ingolia-lab/turbidostat-development/nephelometer/doc/README.md

### Ingolia lab turbidostat

#### [Operating the turbidostat](operation.md)

* [Sterilizing the media reservoir and growth chamber](sterilization.md). 
   
* [Filling the media reservoir](media-fill.md). 
   
* [Starting a turbidostat culture](turbidostat.md).

* [Dissassembly and cleanup](cleanup.md).

#### [Constructing the turbidostat](construction.md)

1. [Electronics](./construction-electronics.md) to assemble the printed circuit board
1. [Housing](./construction-housing.md) to print the enclosure and mount the assembled circuit
1. [Pump](./construction-pump.md) to mount and wire the media pump
1. [Fluidics](./construction-fluidics.md) to assemble the growth chamber, media reservoir, and other associated fluidics
