ingolia-lab/turbidostat-development/nephelometer/doc/raw-images/IMG_1793.JPG

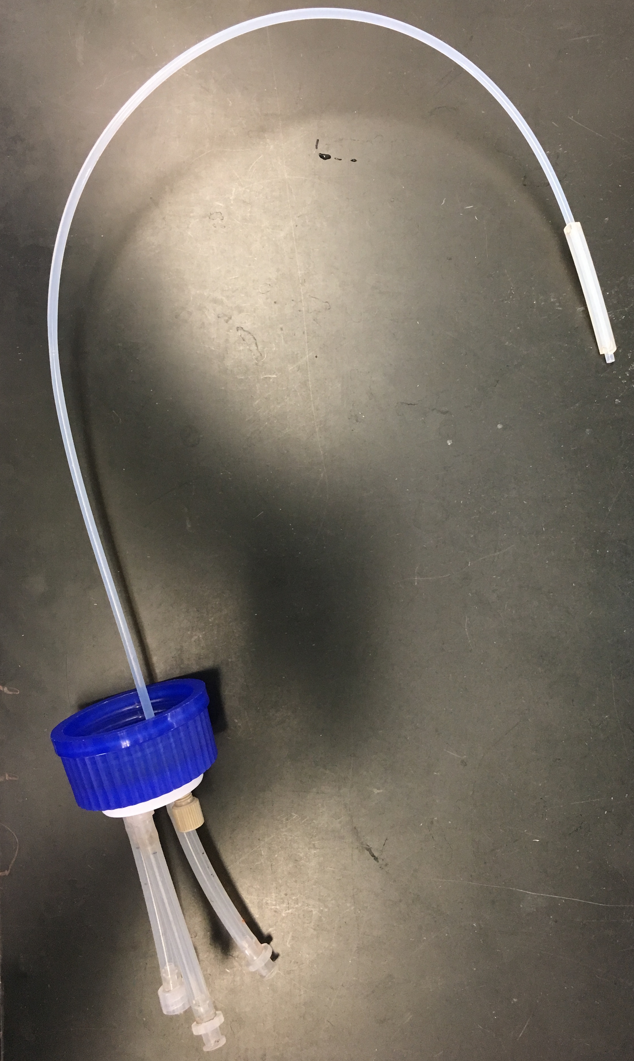
nephelometer/doc/raw-images/IMG_1793.JPG
