ingolia-lab/turbidostat-development/nephelometer/doc/raw-images/IMG_1794.JPG

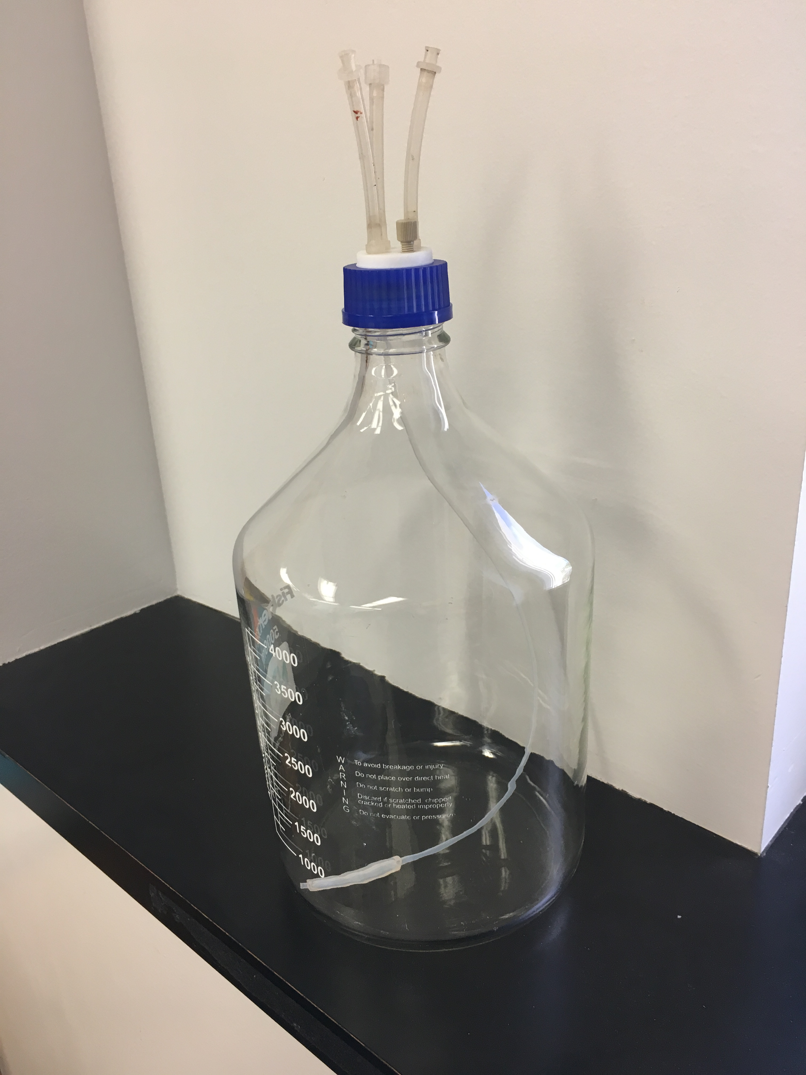
nephelometer/doc/raw-images/IMG_1794.JPG
