ingolia-lab/turbidostat-development/nephelometer/doc/raw-images/IMG_1795.JPG

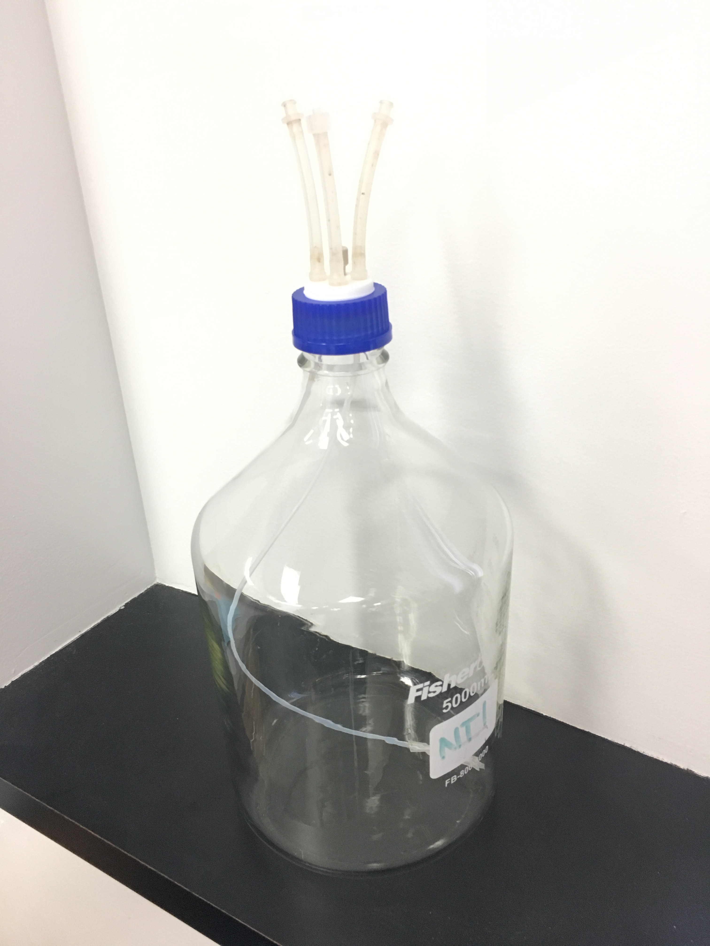
nephelometer/doc/raw-images/IMG_1795.JPG
