ingolia-lab/turbidostat-development/nephelometer/doc/raw-images/IMG_1796.JPG

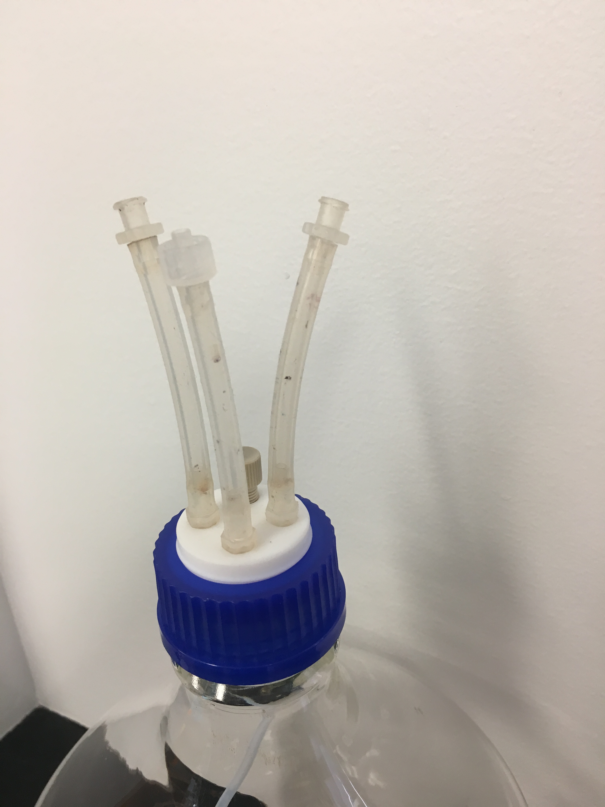
nephelometer/doc/raw-images/IMG_1796.JPG
