ingolia-lab/turbidostat-development/nephelometer/doc/raw-images/IMG_1797.JPG

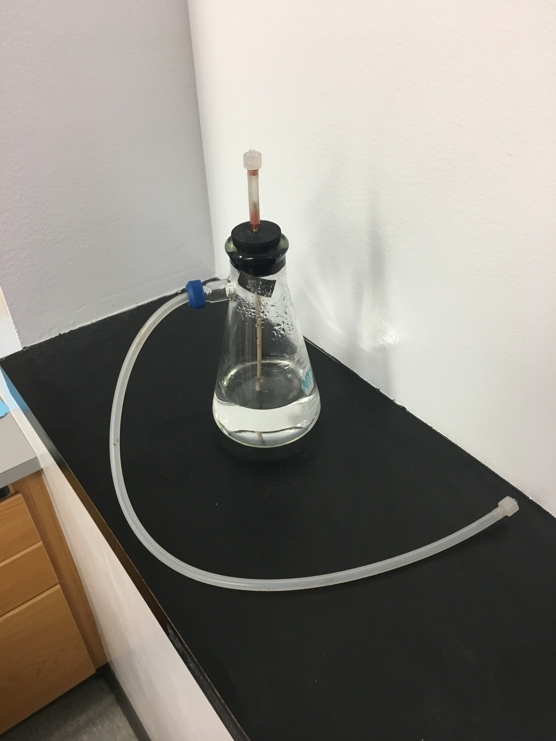
nephelometer/doc/raw-images/IMG_1797.JPG
