ingolia-lab/turbidostat-development/nephelometer/doc/raw-images/IMG_1798.JPG

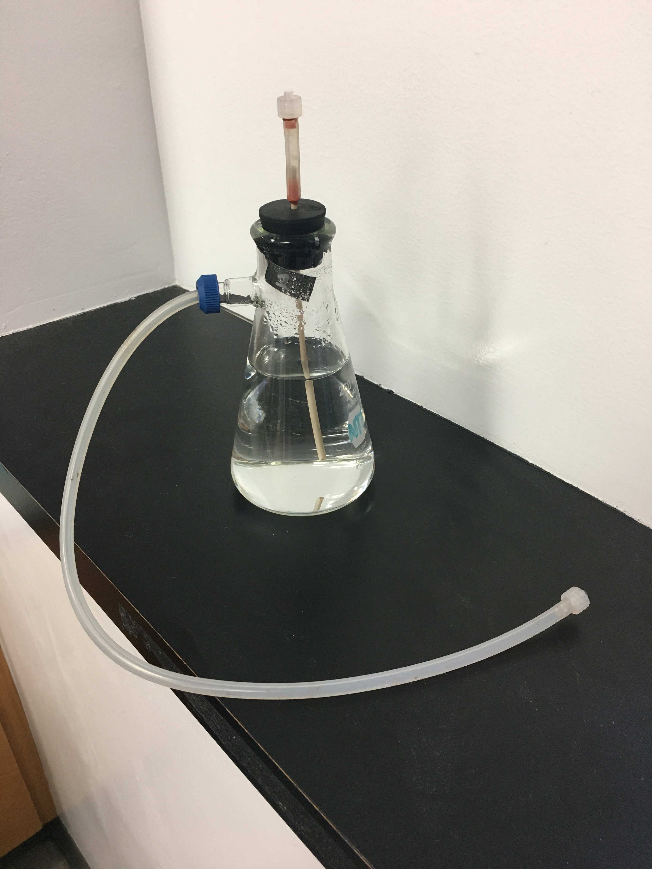
nephelometer/doc/raw-images/IMG_1798.JPG
