ingolia-lab/turbidostat-development/nephelometer/doc/raw-images/IMG_1799.JPG

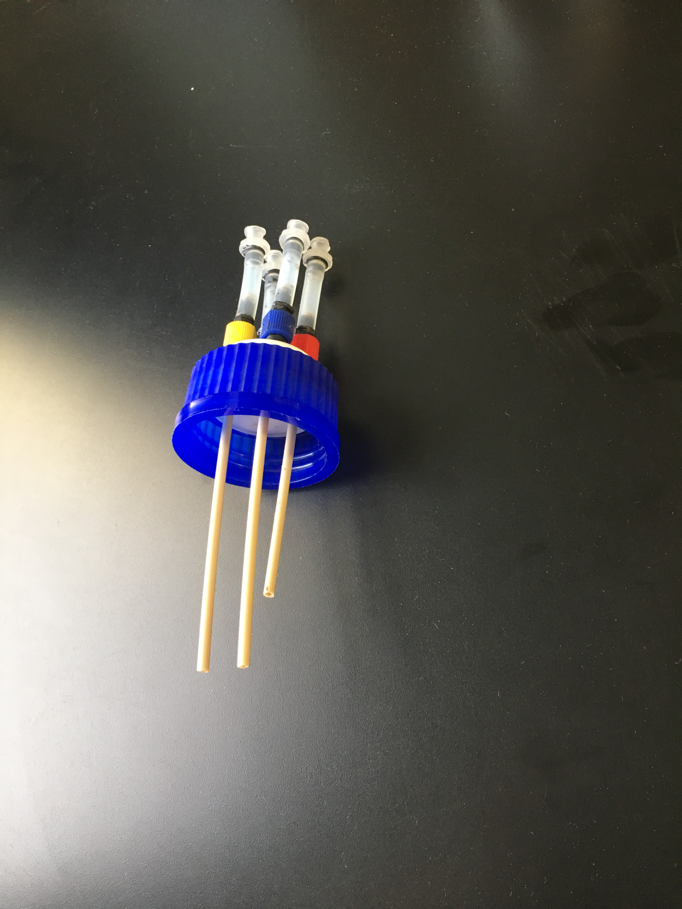
nephelometer/doc/raw-images/IMG_1799.JPG
