ingolia-lab/turbidostat-development/nephelometer/doc/raw-images/IMG_1800.JPG

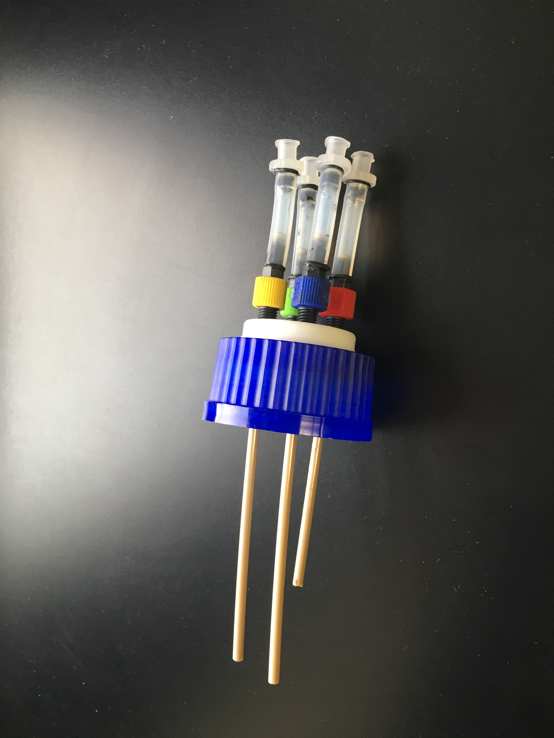
nephelometer/doc/raw-images/IMG_1800.JPG
