ingolia-lab/turbidostat-development/nephelometer/doc/raw-images/IMG_1801.JPG

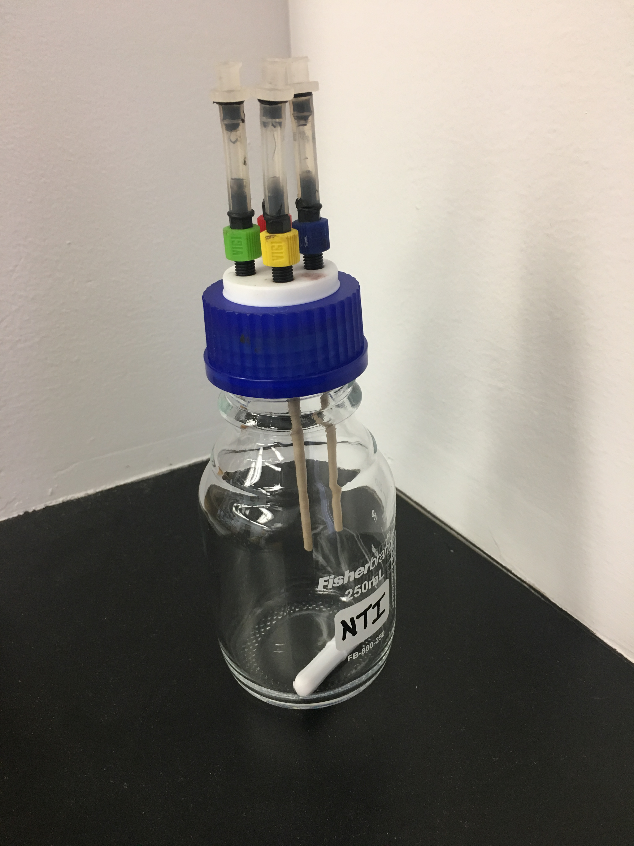
nephelometer/doc/raw-images/IMG_1801.JPG
