ingolia-lab/turbidostat-development/nephelometer/doc/raw-images/IMG_1802.JPG

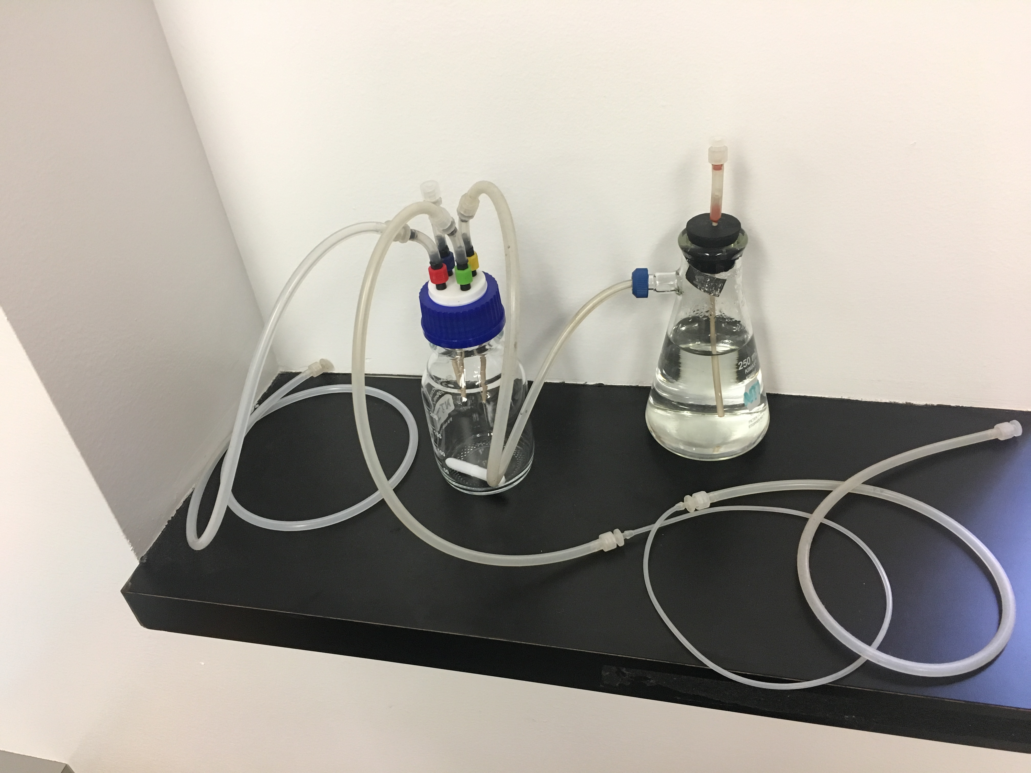
nephelometer/doc/raw-images/IMG_1802.JPG
