ingolia-lab/turbidostat-development/nephelometer/doc/raw-images/IMG_1803.JPG

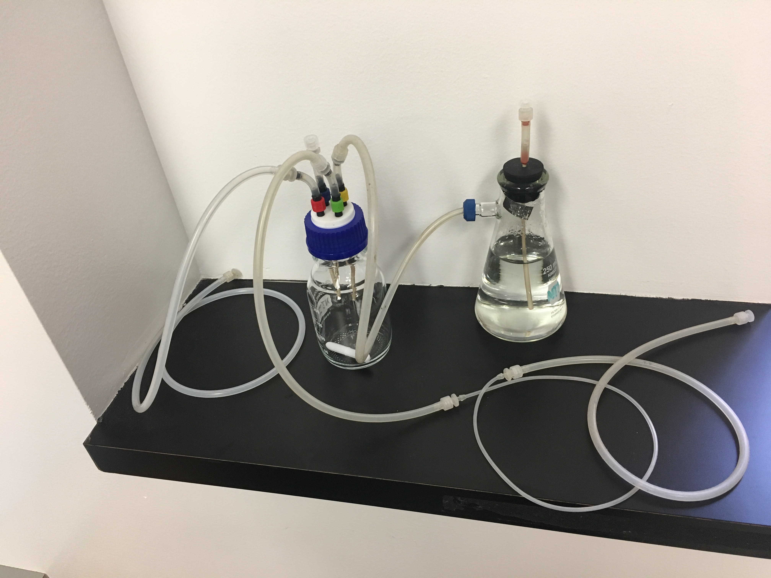
nephelometer/doc/raw-images/IMG_1803.JPG
