ingolia-lab/turbidostat-development/nephelometer/doc/raw-images/IMG_1804.JPG

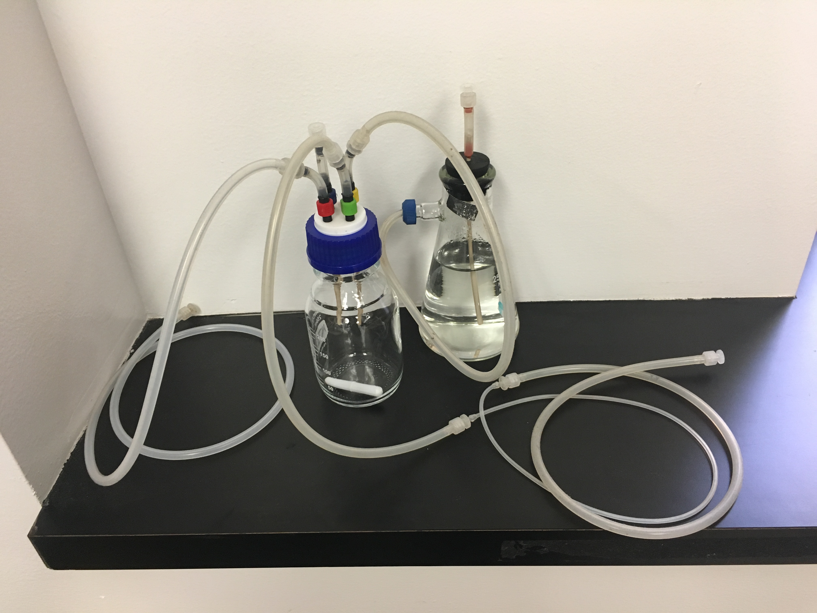
nephelometer/doc/raw-images/IMG_1804.JPG
