ingolia-lab/turbidostat-development/nephelometer/doc/raw-images/IMG_1823.JPG

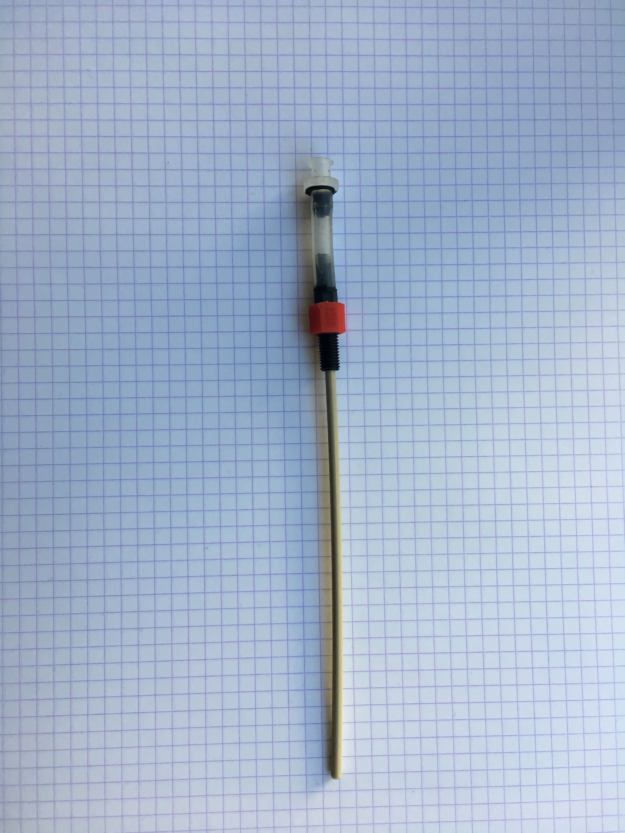
nephelometer/doc/raw-images/IMG_1823.JPG
