ingolia-lab/turbidostat-development/nephelometer/circuitry/teensy/band-motor-teensy-order.txt

1	754-1735-ND	LED1
2	CF14JT4K70CT-ND	R8;R4
1	1N5817FSCT-ND	D1
2	CP1-3523N-ND	J6;J3
1	LM7805CT-ND 	IC1
2	ED2740-ND	J5;J2
1	CP-102A-ND	J1
2	445-5312-ND 	C4;C2
1	AE10383-ND	J4
2	754-1275-ND	LED3;LED2
2	SAM1198-14-ND	MCU1;MCU1
2	CF14JT330RCT-ND	R11;R6
2	1N4935FSCT-ND	D3;D2
1	445-8455-ND	C3
2	IRLB8721PBF-ND	Q2;Q1
1	P5166-ND	C1
2	PN2222ATFCT-ND	T2;T1
7	S1KHCT-ND	R10;R9;R7;R5;R3;R2;R1
