ingolia-lab/turbidostat-development/nephelometer/housing/motor controller.stl

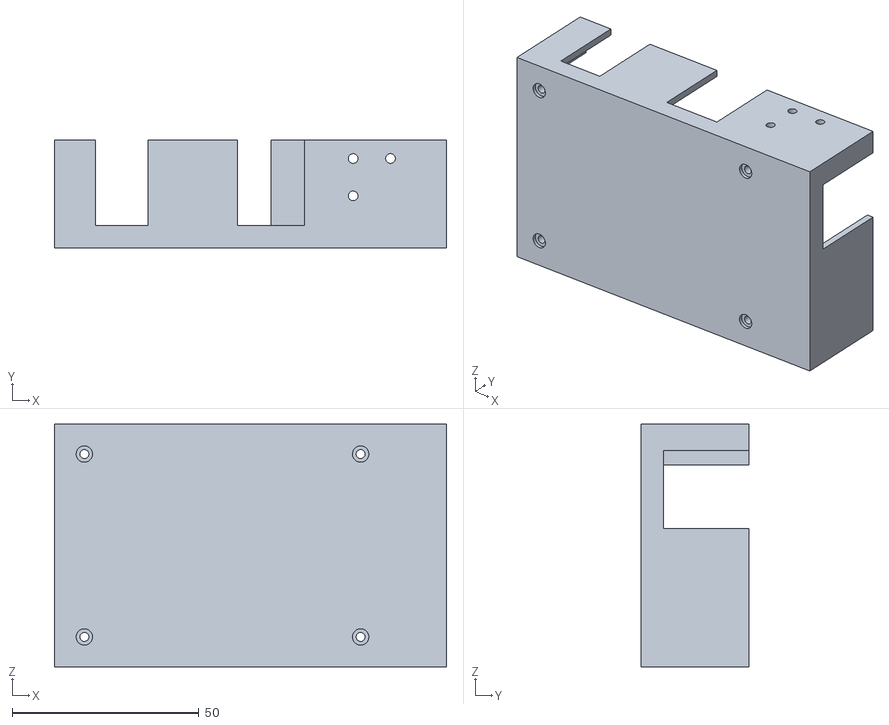
[picture p14: CAD file, 2017-09-29]
nephelometer/housing/motor controller.stl
105.0 x 29.0 x 65.0
