ingolia-lab/turbidostat-development/nephelometer/housing/nephel housing.stl

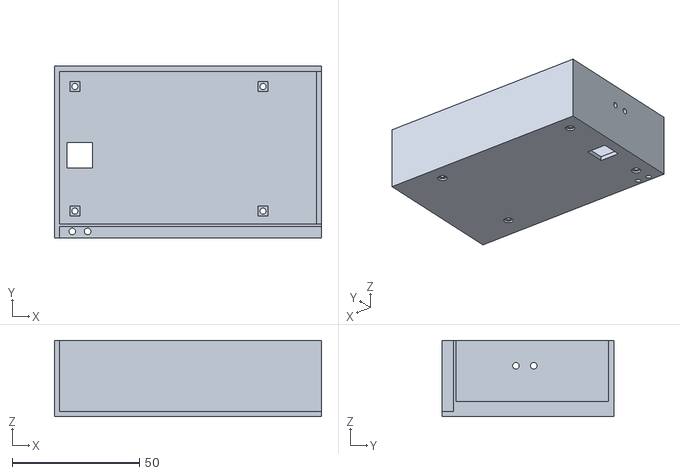
[picture p15: CAD file, 2017-09-29]
nephelometer/housing/nephel housing.stl
105.0 x 67.5 x 30.0
