ingolia-lab/turbidostat-development/nephelometer/housing/500 ml bottle.stl

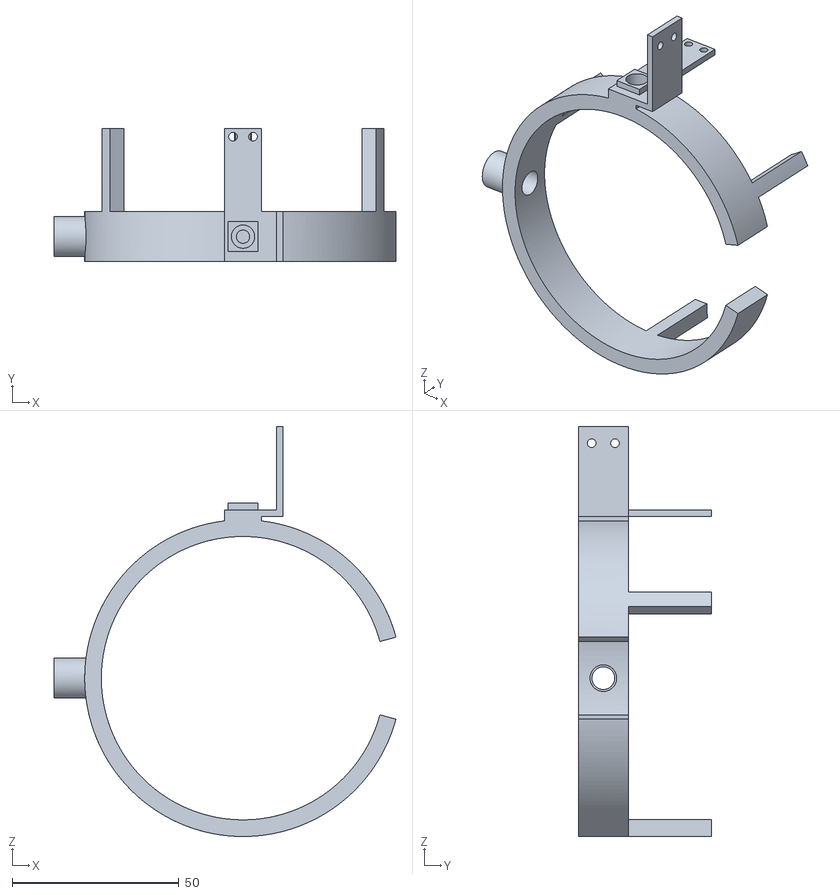
[picture p16: CAD file, 2017-09-29]
nephelometer/housing/500 ml bottle.stl
102.6 x 40.0 x 123.0
