ingolia-lab/turbidostat-development/nephelometer/housing/250 ml bottle.stl

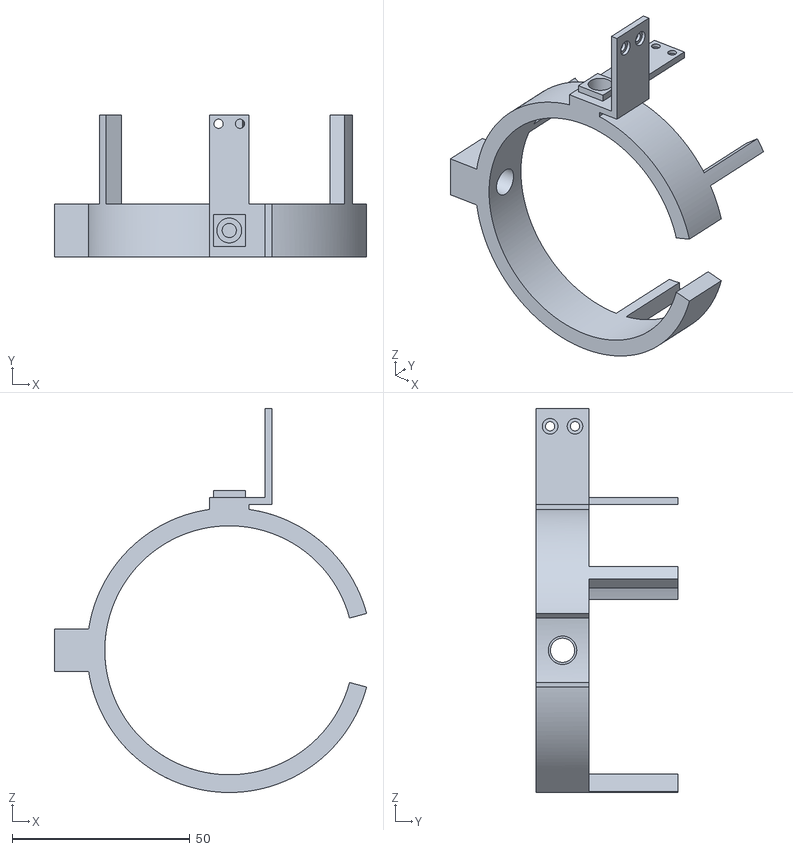
[picture p17: CAD file, 2017-09-29]
nephelometer/housing/250 ml bottle.stl
87.8 x 40.0 x 108.0
