ingolia-lab/turbidostat-development/nephelometer/housing/motor mount.stl

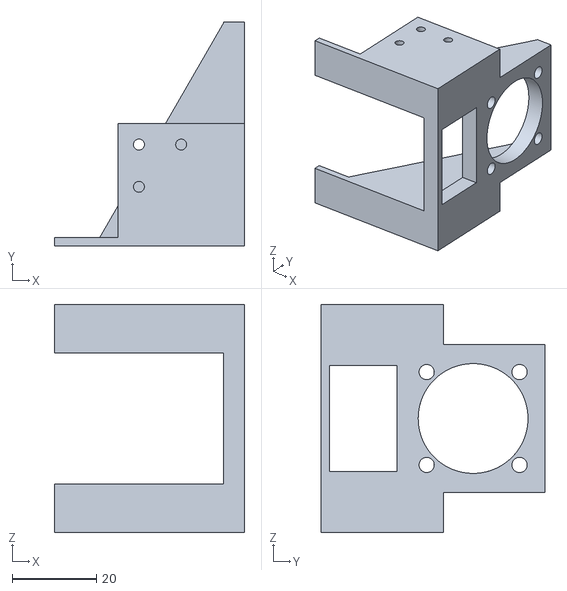
[picture p18: CAD file, 2017-09-29]
nephelometer/housing/motor mount.stl
45.0 x 53.0 x 54.0
