ingolia-lab/turbidostat-development/(list of files, cad)

Other CAD files:
nephelometer/housing/250 ml band v9.f3d
nephelometer/housing/500 ml band v12.f3d
nephelometer/housing/Feather Motor Mount v13.f3d
nephelometer/housing/Feather Nephel Housing v9.f3d
