ingolia-lab/turbidostat-development/nephelometer/doc/construction-housing.md

## Controller Housing

### Ordering information

The housing is assembled from two separate pieces that are produced by 3D printing, painted black, and then screwed together. Files for 3D printing are located in `design/housing`. 

* The `feather-nephel-housing.stl` file prints an enclosed box for the printed circuit board with a square hole for the photodetector. On filament deposition printers, put the widest face of the box on the build plate, with the other walls extending vertically.

* The `250-ml-band.stl` file prints a band that wraps around a 250 ml bottle, with holes for the photodetector and the LED. The `500-ml-band.stl` file prints a band that fits a 500 ml bottle instead. On filament deposition printers, put the band upside-down, with the flat top on the build plate and the legs extending upward.

These files can be printed in PLA plastic on widely available 3D printers (we use an Ultimaker 2+) or fabricated by 3D printing services.

### Equipment

* Small phillips screwdriver

### Consumables
* Krylon Ultra-flat Black 1602 spray paint

  This ultra-flat black spray-paint is highly absorbing in the near-infrared wavelength used to measure turbidity. Many other visually black materials reflect near-IR light.

* M2 x 8mm pan head phillips screw, 316 stainless: McMaster-Carr 90116A015

* M2 hex nut, 316 stainless: McMaster-Carr 94150A305	

  Assembling the housing and mounting the PCB requires eight screws and nuts.

### Assembly

The controller housing is printed as two separate components, a "band" that wraps around the growth chamber and a "box" that houses the detector circuit board. 

1. Remove any support material from the printed parts.

1. Spray paint the band and the box flat black, paying particular attention to the holes for the LED and the photodiode. Allow to dry overnight.

1. Mount the PCB in its housing

   1. Insert the detector circuit board into the box, with the photodiode on the bottom passing through the square opening on the box and into the round hole in the band.

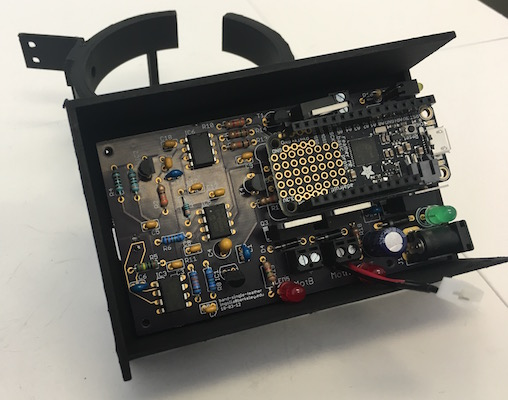
[picture p40: nephelometer/doc/images/housing-01-pcb.jpeg]
housing-01-pcb
      

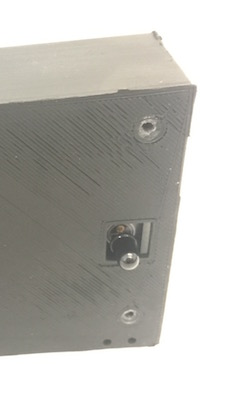
[picture p41: nephelometer/doc/images/housing-02-photodiode.jpeg]
housing-02-photodiode
      

   1. Align the mounting holes on the detector circuit board with the mounting holes on the box.

   1. Insert M2 x 8mm screws through at least two mounting holes on the housing, passing through the circuit board. Thread M2 hex nuts onto the screws and tighten.

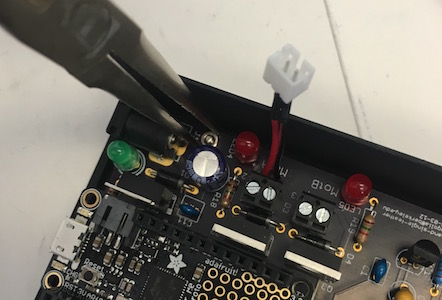
[picture p42: nephelometer/doc/images/housing-03-screw.jpeg]
housing-03-screw
      

      * Some mounting holes are hard to access -- it isn't necessary to use all four screws.

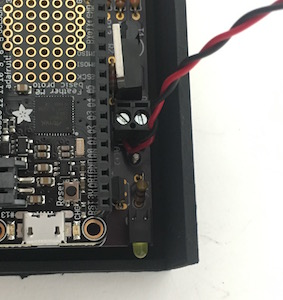
[picture p43: nephelometer/doc/images/housing-04-screw-tight.jpeg]
housing-04-screw-tight
        

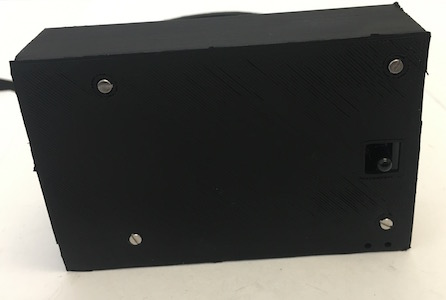
[picture p44: nephelometer/doc/images/housing-05-screwed.jpeg]
housing-05-screwed
      

1. Attach the band to the PCB housing

   1. Fit the band against the box. 

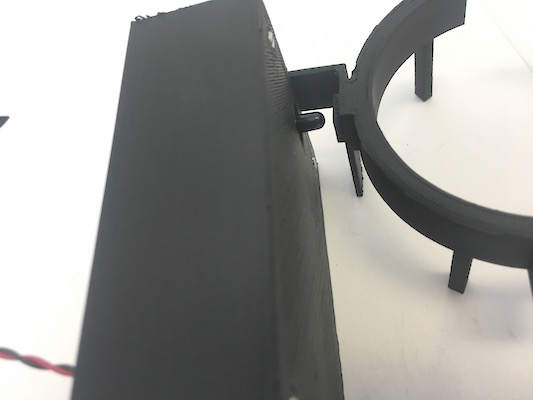
[picture p45: nephelometer/doc/images/housing-06-band.jpeg]
housing-06-band
      

   1. The rectangular arm on the band should align with holes on the side of the box. 

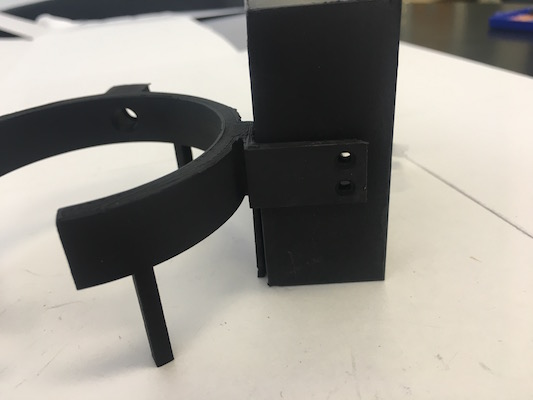
[picture p46: nephelometer/doc/images/housing-07-band-side.jpeg]
housing-07-band-side
      

      * The two flat arms extending from the band with screw holes should align with screw holes on the box.
   
   1. Insert M2 x 8mm screws through the holes in the band into the box.

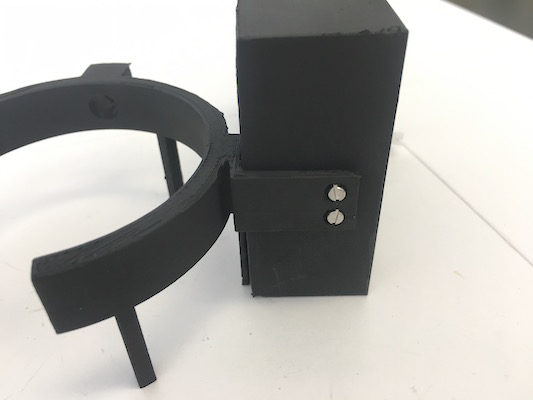
[picture p47: nephelometer/doc/images/housing-08-screw-side.jpeg]
housing-08-screw-side
      

   1. Thread M2 hex nuts onto the screws and tighten.
   
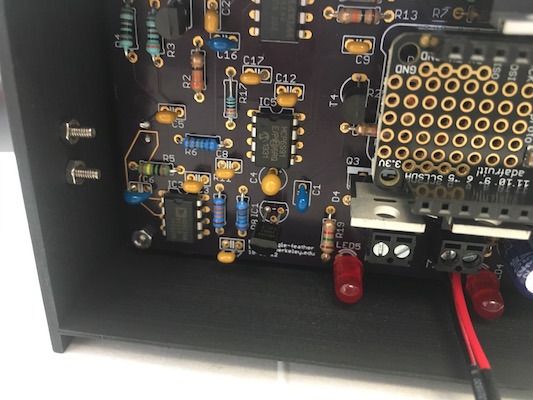
[picture p48: nephelometer/doc/images/housing-09-side-nut.jpeg]
housing-09-side-nut
      
      
   1. The rectangular, flat leg on the band should align with holes at the bottom of the box. Insert M2 x 8mm screws through the holes in the band into the box.
   
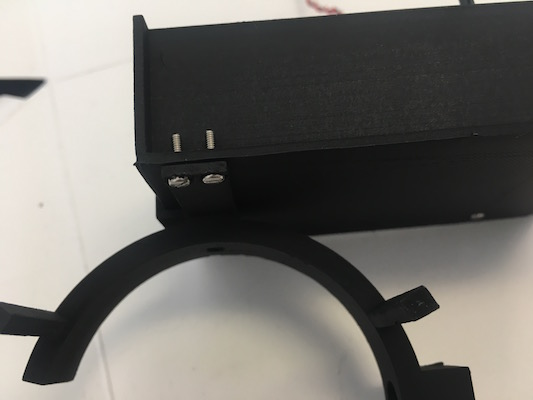
[picture p49: nephelometer/doc/images/housing-10-bottom-screw.jpeg]
housing-10-bottom-screw
      
   
   1. Thread M2 hex nuts onto the screws and tighten.
   
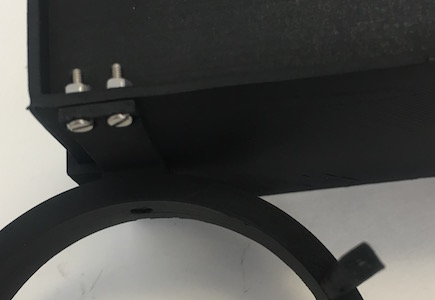
[picture p50: nephelometer/doc/images/housing-11-bottom-nut.jpeg]
housing-11-bottom-nut
      
   
1. Mount the LED in the band

   1. Insert the flanged LED holder into the hole on the inside of the band.
   
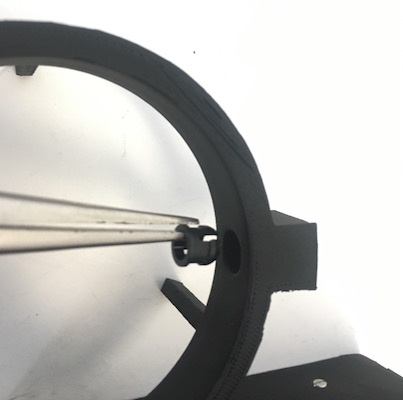
[picture p51: nephelometer/doc/images/housing-12-led-mount.jpeg]
housing-12-led-mount
      
      
   1. Press the LED holder into the hole until the flanges extend out the back.
   
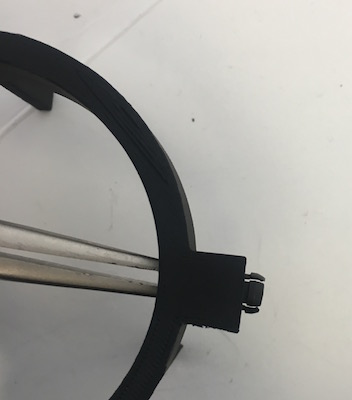
[picture p52: nephelometer/doc/images/housing-13-led-mount.jpeg]
housing-13-led-mount
      
      
   1. Thread the retaining ring over the LED onto the cables Insert the LED into the flanges.
   
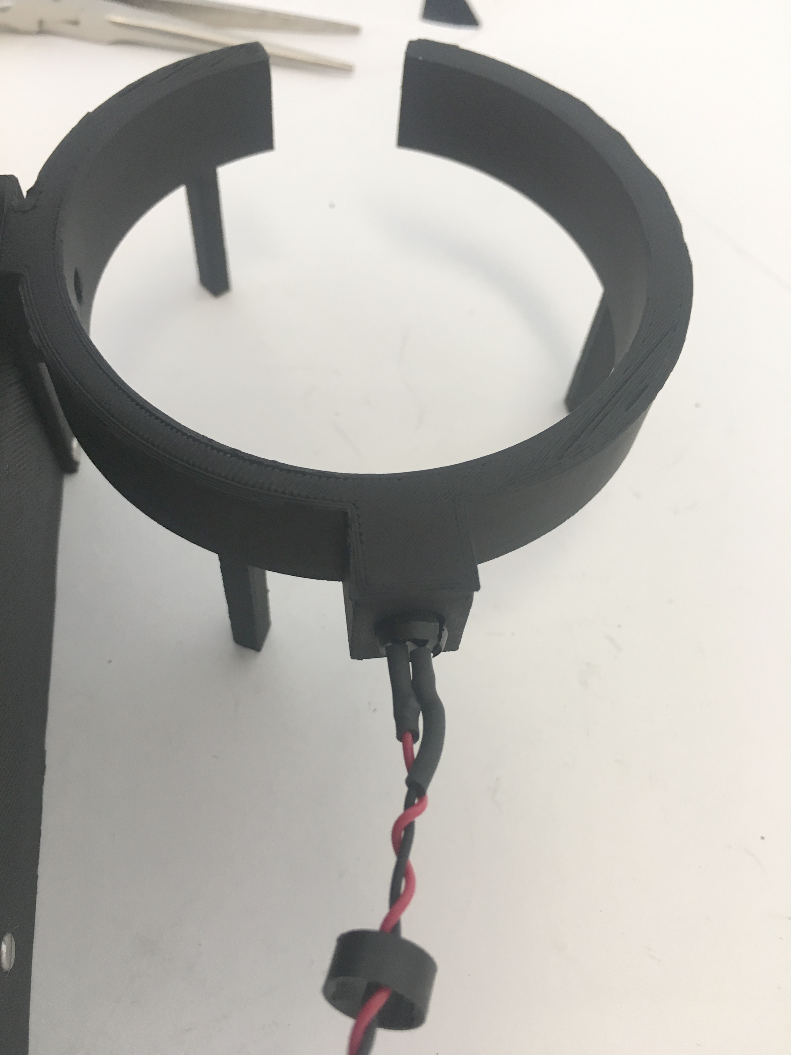
[picture p53: nephelometer/doc/images/housing-14-led-ring.jpeg]
housing-14-led-ring
      
      
   1. Slide the ring over the flanges to clamp the LED in place.
   
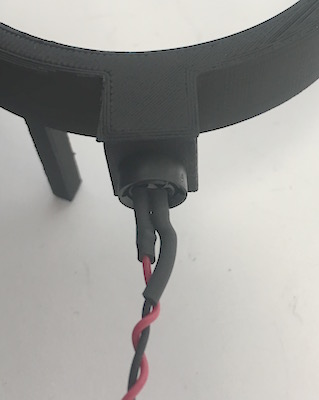
[picture p54: nephelometer/doc/images/housing-15-led.jpeg]
housing-15-led
