ingolia-lab/turbidostat-development/nephelometer/doc/operation.md

### Consumables

* Sterivex pressure-driven 0.22µm PES membrane filter, Luer: EMD Millipore SVGPL10RC

  Used to sterilize liquid media

* Acrodisk 25mm Luer syringe filter, 0.22µm, PES:  VWR 28145-501

  Used to sterilize the air input and various vents

* 5 ml Luer syringe: BD Biosciences 309646, VWR BD309646

  Used to inoculate the turbidostat

---

#### [Sterilizing the media reservoir and growth chamber](sterilization.md). 

   These can be sterilized well in advance.
   
#### [Filling the media reservoir](media-fill.md). 
   
   The media reservoir can be filled in advance and stored as appropriate for the specific liquid media used in the experiment. The media reservoir can also be refilled during operation, and the media source can be switched between reservoirs to change culture conditions.
   
#### [Starting a turbidostat culture](turbidostat.md).

   * Final assembly of the sterilized growth chamber
   * Filling the growth chamber with media
   * Inoculating the culture
   * Starting the turbidostat controller
   
#### [Dissassembly and cleanup](cleanup.md).
