ingolia-lab/turbidostat-development/nephelometer/doc/images/growth-chamber-assembled.jpeg

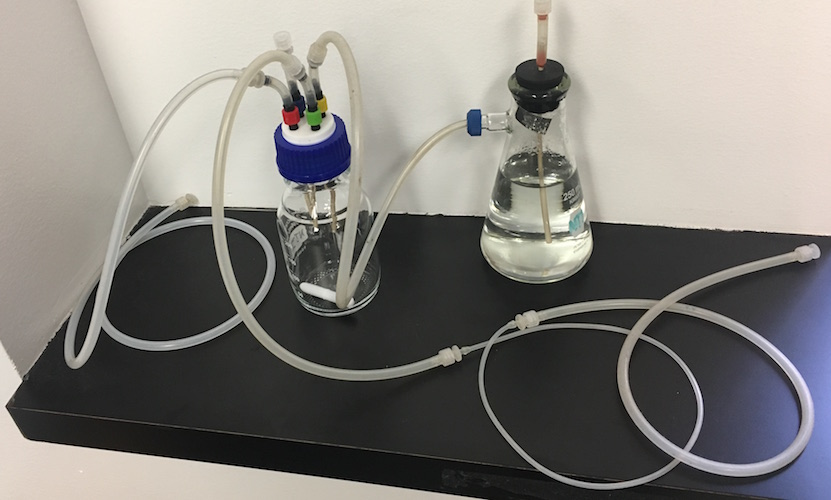
nephelometer/doc/images/growth-chamber-assembled.jpeg
