ingolia-lab/turbidostat-development/nephelometer/circuitry/feather/band-single-feather.brd

## EAGLE design nephelometer/circuitry/feather/band-single-feather.brd (2018-03-13)

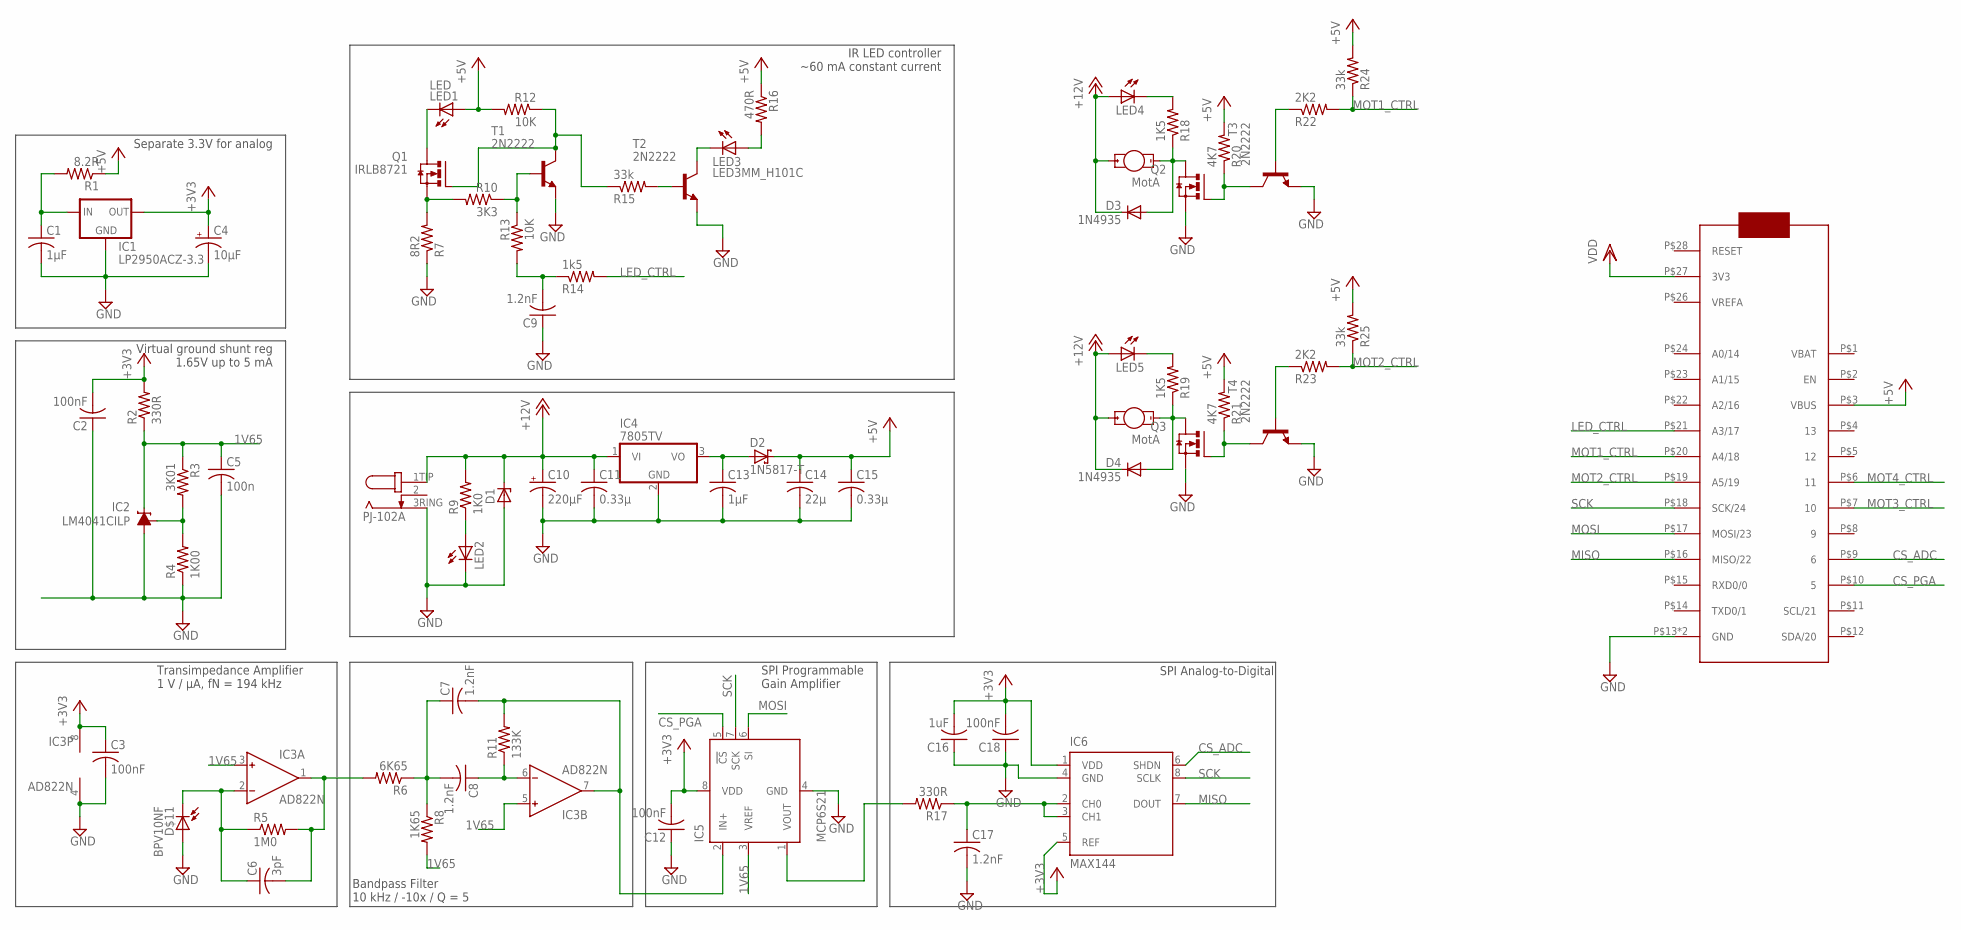
[picture p75: schematic band-single-feather.sch]

Parts:
C1, C13: 1µF; C025-030X050; DIGIKEY# 445-5318-ND
C2, C3, C12, C18: 100nF; C025-025X050; DIGIKEY# BC1084CT-ND
C4: 10µF; E2,5-5; DIGIKEY# 478-8042-1-ND
C5: 100n; C025-025X050; DIGIKEY# BC1084CT-ND
C6: 3pF; C025-024X044; DIGIKEY# 445-8377-ND
C7, C8, C9, C17: 1.2nF; C025-025X050; DIGIKEY# BC1026CT-ND
C10: 220µF; E3,5-8; DIGIKEY# P5166-ND
C11, C15: 0.33µ; C025-050X050; DIGIKEY# 445-5312-ND
C14: 22µ; C050-045X075; DIGIKEY# 445-8455-ND
C16: 1uF; C025-025X050; DIGIKEY# 445-5318-ND
D1: ZENER-DIODEF126-10; F126Z10; DIGIKEY# SA12ALFCT-ND
D2: 1N5817-T; DO41-7.6; DIGIKEY# 1N5817FSCT-ND
D3, D4: 1N4935; DO41-10; DIGIKEY# 1N4935GOS-ND
D$11: BPV10NF; LED5MM; DIGIKEY# 751-1002-ND
IC1: LP2950ACZ-3.3; TO92; DIGIKEY# LP2950ACZ-3.3/NOPB-ND
IC2: LM4041CILP; LP_O-PBCY-W3; DIGIKEY# 296-22173-1-ND
IC3: AD822N; DIL08; DIGIKEY# AD823ANZ-ND
IC4: 7805TV; TO220V; DIGIKEY# LM7805CT-ND
IC5: MCP6S21; DIL08; DIGIKEY# MCP6S91-E/P-ND
IC6: MAX144; DIL08; DIGIKEY# MAX144ACPA+-ND
IC7: FEATHER_M0; DIGIKEY# 1528-1531-ND
J1: PJ-102A; DIGIKEY# CP-102A-ND
J2, J3: MotA; 1X02_3.5MM_MOT; DIGIKEY# ED2740-ND
LED1: LED; 1X02_3.5MM; DIGIKEY# 475-3002-ND
LED2: LED5MM; DIGIKEY# 754-1735-ND
LED3: LED3MM_H101C; DIGIKEY# 754-1727-ND
LED4, LED5: LED3MM; DIGIKEY# 754-1275-ND
Q1, Q2, Q3: IRLB8721; TO220BV; DIGIKEY# IRLB8721PBF-ND
R1: 8.2R; 0207/9; DIGIKEY# S8.2HCT-ND
R2: 330R; 0207/9; DIGIKEY# CF14JT330RCT-ND
R3: 3K01; 0207/9; DIGIKEY# RNF14FTD3K01CT-ND
R4: 1K00; 0207/9; DIGIKEY# RNF14FTD1K00CT-ND
R5: 1M0; 0207/9; DIGIKEY# RNV14FAL1M00CT-ND
R6: 6K65; 0207/9; DIGIKEY# 6.65KXBK-ND
R7: 8R2; 0207/9; DIGIKEY# S8.2HCT-ND
R8: 1K65; 0207/9; DIGIKEY# 1.65KXBK-ND
R9: 1K0; 0207/9; DIGIKEY# S1KHCT-ND
R10: 3K3; 0207/9; DIGIKEY# CF14JT3K30CT-ND
R11: 133K; 0207/9; DIGIKEY# 133KXBK-ND
R12, R13: 10K; 0207/9; DIGIKEY# CF14JT10K0CT-ND
R14: 1k5; 0207/9; DIGIKEY# CF14JT1K50CT-ND
R15, R24, R25: 33k; 0207/9; DIGIKEY# CF14JT33K0CT-ND
R16: 470R; 0207/5V; DIGIKEY# CF14JT470RCT-ND
R17: 330R; 0207/9; DIGIKEY# S330CACT-ND
R18, R19: 1K5; 0207/10; DIGIKEY# CF14JT1K50CT-ND
R20, R21: 4K7; 0207/10; DIGIKEY# CF14JT4K70CT-ND
R22, R23: 2K2; 0207/10; DIGIKEY# CF14JT2K20CT-ND
T1, T2, T3, T4: 2N2222; TO92-EBC-OVAL; DIGIKEY# PN2222ATFCT-ND

Connections:
1V65: C5.1, IC2.2 (C), IC3.3 (IN+), IC3.5 (IN+), IC5.3 (VREF), R2.1, R3.1, R8.2
+3V3: C2.2, C3.1, C4.+, C12.2, C16.2, C18.2, IC1.1 (OUT), IC3.8 (V+), IC5.8 (VDD), IC6.1 (VDD), IC6.5 (REF), R2.2
+5V: C14.1, C15.1, D2.C, IC7.P$3 (VBUS), LED1.1A (A), R1.1, R12.2, R16.1, R20.2, R21.2, R24.2, R25.2
+12V: C10.+, C11.1, D1.C, D3.C, D4.C, IC4.1 (VI), J1.1TIP (3TIP), J2.1A (+), J3.1A (+), LED4.A, LED5.A, R9.2
BPF: C7.2, IC3.7 (OUT), IC5.2 (IN+), R11.2
CS_ADC: IC6.6 (SHDN), IC7.P$9 (6)
CS_PGA: IC5.5 (!CS), IC7.P$10 (5)
FB: C6.1, D$11.K, IC3.2 (IN-), R5.1
GND: C1.2, C2.1, C3.2, C4.-, C5.2, C9.1, C10.-, C11.2, C12.1, C13.2, C14.2, C15.2, C16.1, C17.2, C18.1, D1.A, D$11.A, IC1.2 (GND), IC2.3 (A), IC3.4 (V-), IC4.2 (GND), IC5.4 (GND), IC6.4 (GND), IC7.P$13 (GND), IC7.P$25 (GND), J1.3RING (1RING), LED2.K (C), Q2.S, Q3.S, R4.1, R7.1, T1.E, T2.E, T3.E, T4.E
LED_CTRL: IC7.P$21 (A3/17), R14.2
MISO: IC6.7 (DOUT), IC7.P$16 (MISO/22)
MOSI: IC5.6 (SI), IC7.P$17 (MOSI/23)
MOT1: Q2.G, R20.1, T3.C
MOT1_CTRL: IC7.P$20 (A4/18), R22.2, R24.1
MOT2: Q3.G, R21.1, T4.C
MOT2_CTRL: IC7.P$19 (A5/19), R23.2, R25.1
MOT3_CTRL: IC7.P$7 (10)
MOT4_CTRL: IC7.P$6 (11)
unnamed: LED2.A, R9.1
unnamed: C7.1, C8.2, R6.1, R8.1
unnamed: IC5.1 (VOUT), R17.2
unnamed: D3.A, J2.2K (-), Q2.D, R18.1
unnamed: LED4.K (C), R18.2
unnamed: R22.1, T3.B
unnamed: Q1.G, R12.1, R15.1, T1.C
unnamed: C8.1, IC3.6 (IN-), R11.1
unnamed: D4.A, J3.2K (-), Q3.D, R19.1
unnamed: LED3.A, R16.2
unnamed: LED3.K, T2.C
unnamed: R10.1, R13.1, T1.B
unnamed: Q1.S, R7.2, R10.2
unnamed: C9.2, R13.2, R14.1
unnamed: R15.2, T2.B
unnamed: LED1.2K (K), Q1.D
unnamed: LED5.K (C), R19.2
unnamed: R23.1, T4.B
unnamed: C13.1, D2.A, IC4.3 (VO)
unnamed: C17.1, IC6.2 (CH0), IC6.3 (CH1), R17.1
unnamed: C1.1, IC1.3 (IN), R1.2
unnamed: IC2.1 (FB), R3.2, R4.2
SCK: IC5.7 (SCK), IC6.8 (SCLK), IC7.P$18 (SCK/24)
TIA: C6.2, IC3.1 (OUT), R5.2, R6.2
VDD: IC7.P$27 (3V3)

Notes on the sheet:
Transimpedance Amplifier 1 V / µA, fN = 194 kHz
Bandpass Filter 10 kHz / -10x / Q = 5
Virtual ground shunt reg 1.65V up to 5 mA
IR LED controller ~60 mA constant current
SPI Programmable Gain Amplifier
Separate 3.3V for analog
SPI Analog-to-Digital

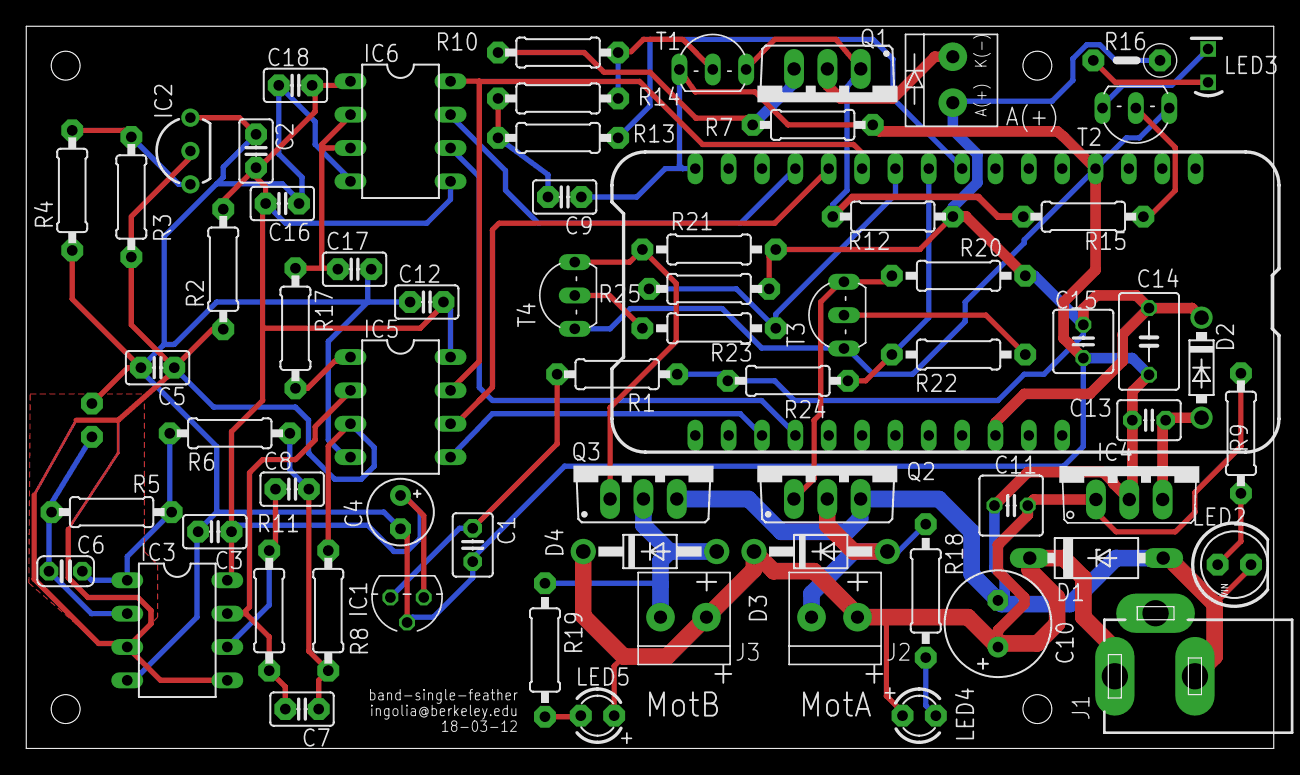
[picture p76: board band-single-feather.brd from above]

Board: 2 copper layers, 95.0 x 55.0 mm, 74 parts (1 on the bottom side), 40 nets.

Other parts of the board:
U$1, U$2, U$3, U$4: M2MOUNT
