ingolia-lab/turbidostat-development/nephelometer/circuitry/feather/band-dsp-feather.brd

## EAGLE design nephelometer/circuitry/feather/band-dsp-feather.brd (2017-06-30)

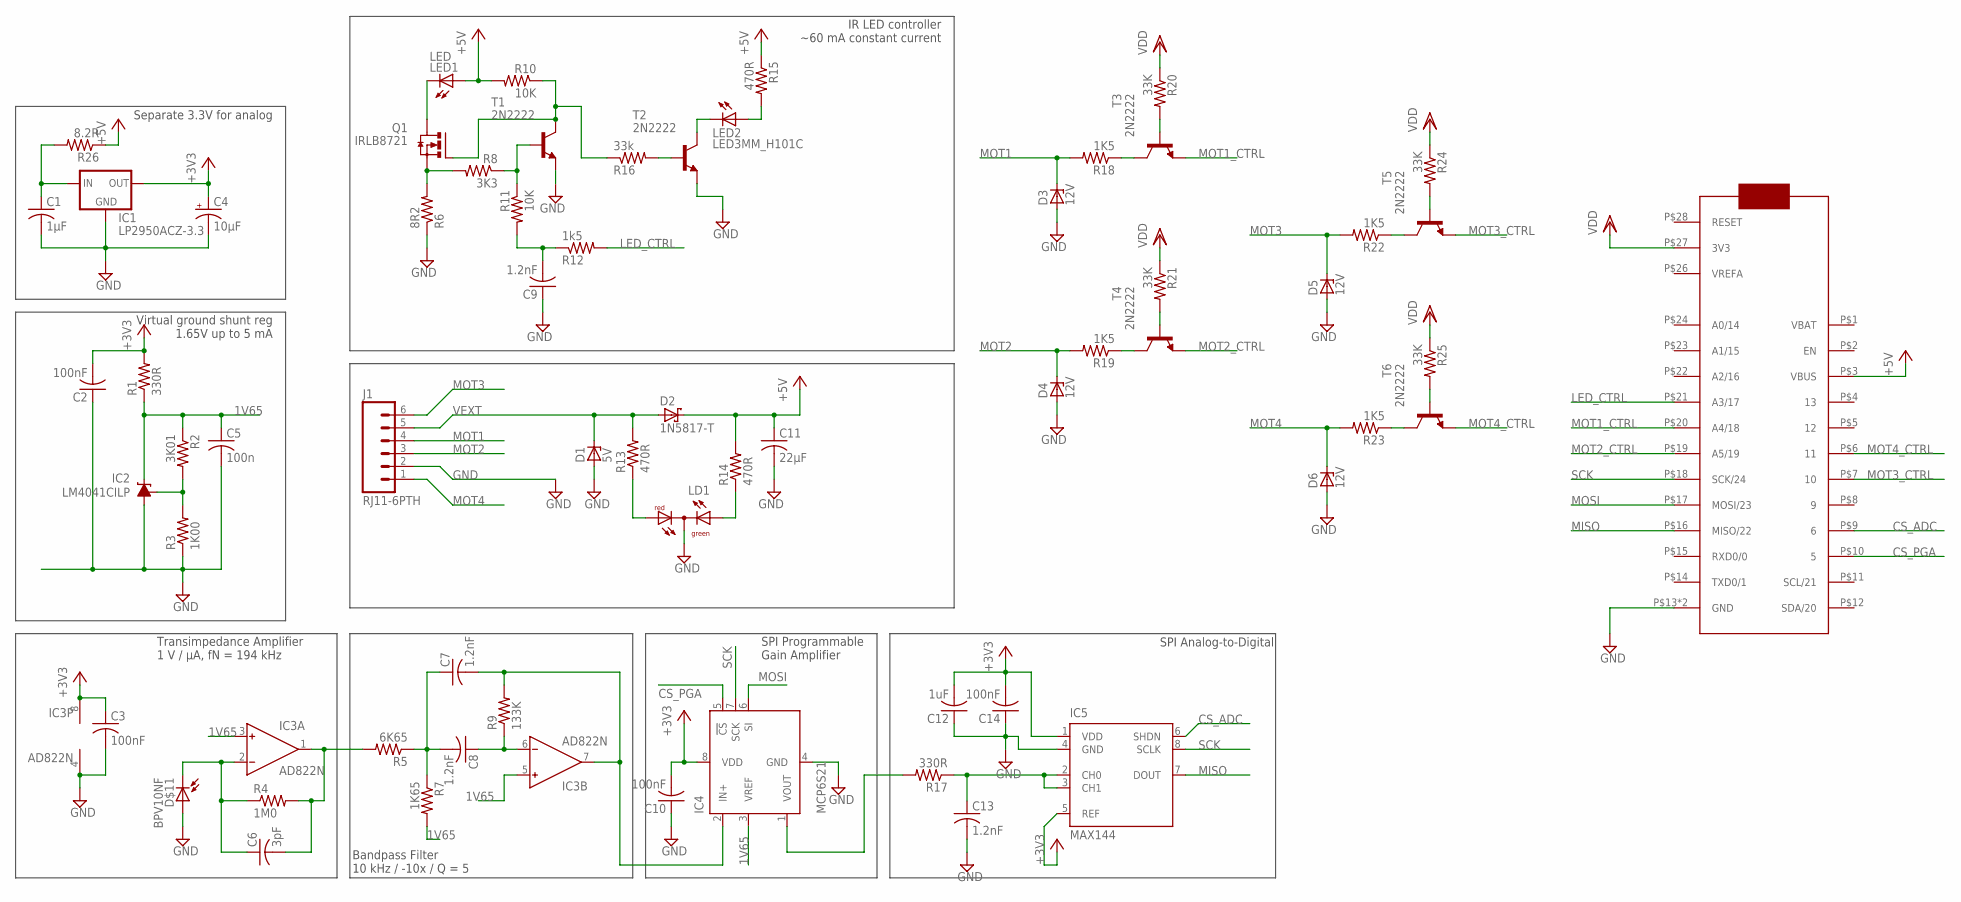
[picture p77: schematic band-dsp-feather.sch]

Parts:
C1: 1µF; C025-030X050; DIGIKEY# 445-5318-ND
C2, C3, C10, C14: 100nF; C025-025X050; DIGIKEY# BC1084CT-ND
C4: 10µF; E2,5-5; DIGIKEY# 478-8042-1-ND
C5: 100n; C025-025X050; DIGIKEY# BC1084CT-ND
C6: 3pF; C025-024X044; DIGIKEY# 445-8377-ND
C7, C8, C9, C13: 1.2nF; C025-025X050; DIGIKEY# BC1026CT-ND
C11: 22µF; C050-045X075; DIGIKEY# 445-8455-ND
C12: 1uF; C025-025X050; DIGIKEY# 445-5318-ND
D1: 5V; F126Z10; DIGIKEY# SA5.0ALFCT-ND
D2: 1N5817-T; DO41-7.6; DIGIKEY# 1N5817FSCT-ND
D3, D4, D5, D6: 12V; F126Z10; DIGIKEY# SA12ALFCT-ND
D$11: BPV10NF; LED5MM; DIGIKEY# 751-1002-ND
IC1: LP2950ACZ-3.3; TO92; DIGIKEY# LP2950ACZ-3.3/NOPB-ND
IC2: LM4041CILP; LP_O-PBCY-W3; DIGIKEY# 296-22173-1-ND
IC3: AD822N; DIL08; DIGIKEY# AD823ANZ-ND
IC4: MCP6S21; DIL08; DIGIKEY# MCP6S91-E/P-ND
IC5: MAX144; DIL08; DIGIKEY# MAX144ACPA+-ND
IC6: FEATHER_M0; DIGIKEY# 1528-1531-ND
J1: RJ11-6PTH; RJ11-6; DIGIKEY# AE10383-ND
LD1: DUOLED-RG-C; DUOLED-C-5MM; DIGIKEY# 754-1221-ND
LED1: LED; 1X02_3.5MM; DIGIKEY# 475-3002-ND
LED2: LED3MM_H101C; DIGIKEY# 754-1727-ND
Q1: IRLB8721; TO220BV; DIGIKEY# IRLB8721PBF-ND
R1: 330R; 0207/9; DIGIKEY# CF14JT330RCT-ND
R2: 3K01; 0207/9; DIGIKEY# RNF14FTD3K01CT-ND
R3: 1K00; 0207/9; DIGIKEY# RNF14FTD1K00CT-ND
R4: 1M0; 0207/9; DIGIKEY# RNV14FAL1M00CT-ND
R5: 6K65; 0207/9; DIGIKEY# 6.65KXBK-ND
R6: 8R2; 0207/9; DIGIKEY# S8.2HCT-ND
R7: 1K65; 0207/9; DIGIKEY# 1.65KXBK-ND
R8: 3K3; 0207/9; DIGIKEY# CF14JT3K30CT-ND
R9: 133K; 0207/9; DIGIKEY# 133KXBK-ND
R10, R11: 10K; 0207/9; DIGIKEY# CF14JT10K0CT-ND
R12: 1k5; 0207/9; DIGIKEY# CF14JT1K50CT-ND
R13, R14: 470R; 0207/9; DIGIKEY# CF14JT470RCT-ND
R15: 470R; 0207/5V; DIGIKEY# CF14JT470RCT-ND
R16: 33k; 0207/9; DIGIKEY# CF14JT33K0CT-ND
R17: 330R; 0207/9; DIGIKEY# S330CACT-ND
R18, R19, R22, R23: 1K5; 0207/9; DIGIKEY# CF14JT1K50CT-ND
R20, R21, R24, R25: 33K; 0207/9; DIGIKEY# CF14JT33K0CT-ND
R26: 8.2R; 0207/9; DIGIKEY# S8.2HCT-ND
T1, T2, T3, T4, T5, T6: 2N2222; TO92-EBC-OVAL; DIGIKEY# PN2222ATFCT-ND

Connections:
1V65: C5.1, IC2.2 (C), IC3.3 (IN+), IC3.5 (IN+), IC4.3 (VREF), R1.1, R2.1, R7.2
+3V3: C2.2, C3.1, C4.+, C10.2, C12.2, C14.2, IC1.1 (OUT), IC3.8 (V+), IC4.8 (VDD), IC5.1 (VDD), IC5.5 (REF), R1.2
+5V: C11.1, D2.C, IC6.P$3 (VBUS), LED1.1A (A), R10.2, R14.2, R15.1, R26.1
BPF: C7.2, IC3.7 (OUT), IC4.2 (IN+), R9.2
CS_ADC: IC5.6 (SHDN), IC6.P$9 (6)
CS_PGA: IC4.5 (!CS), IC6.P$10 (5)
FB: C6.1, D$11.K, IC3.2 (IN-), R4.1
GND: C1.2, C2.1, C3.2, C4.-, C5.2, C9.1, C10.1, C11.2, C12.1, C13.2, C14.1, D1.A, D3.A, D4.A, D5.A, D6.A, D$11.A, IC1.2 (GND), IC2.3 (A), IC3.4 (V-), IC4.4 (GND), IC5.4 (GND), IC6.P$13 (GND), IC6.P$25 (GND), J1.2, LD1.C, R3.1, R6.1, T1.E, T2.E
LED_CTRL: IC6.P$21 (A3/17), R12.2
MISO: IC5.7 (DOUT), IC6.P$16 (MISO/22)
MOSI: IC4.6 (SI), IC6.P$17 (MOSI/23)
MOT1: D3.C, J1.4, R18.2
MOT1_CTRL: IC6.P$20 (A4/18), T3.E
MOT2: D4.C, J1.3, R19.2
MOT2_CTRL: IC6.P$19 (A5/19), T4.E
MOT3: D5.C, J1.6, R22.2
MOT3_CTRL: IC6.P$7 (10), T5.E
MOT4: D6.C, J1.1, R23.2
MOT4_CTRL: IC6.P$6 (11), T6.E
unnamed: R19.1, T4.C
unnamed: R21.2, T4.B
unnamed: C7.1, C8.2, R5.1, R7.1
unnamed: IC4.1 (VOUT), R17.2
unnamed: R22.1, T5.C
unnamed: R24.2, T5.B
unnamed: LD1.AX (AG), R14.1
unnamed: Q1.G, R10.1, R16.1, T1.C
unnamed: C8.1, IC3.6 (IN-), R9.1
unnamed: R23.1, T6.C
unnamed: LED2.A, R15.2
unnamed: LED2.K, T2.C
unnamed: R8.1, R11.1, T1.B
unnamed: Q1.S, R6.2, R8.2
unnamed: C9.2, R11.2, R12.1
unnamed: R16.2, T2.B
unnamed: LED1.2K (K), Q1.D
unnamed: R18.1, T3.C
unnamed: R20.2, T3.B
unnamed: R25.2, T6.B
unnamed: LD1.AR, R13.1
unnamed: C13.1, IC5.2 (CH0), IC5.3 (CH1), R17.1
unnamed: C1.1, IC1.3 (IN), R26.2
unnamed: IC2.1 (FB), R2.2, R3.2
SCK: IC4.7 (SCK), IC5.8 (SCLK), IC6.P$18 (SCK/24)
TIA: C6.2, IC3.1 (OUT), R4.2, R5.2
VDD: IC6.P$27 (3V3), R20.1, R21.1, R24.1, R25.1
VEXT: D1.C, D2.A, J1.5, R13.2

Notes on the sheet:
Transimpedance Amplifier 1 V / µA, fN = 194 kHz
Bandpass Filter 10 kHz / -10x / Q = 5
Virtual ground shunt reg 1.65V up to 5 mA
IR LED controller ~60 mA constant current
SPI Programmable Gain Amplifier
Separate 3.3V for analog
SPI Analog-to-Digital

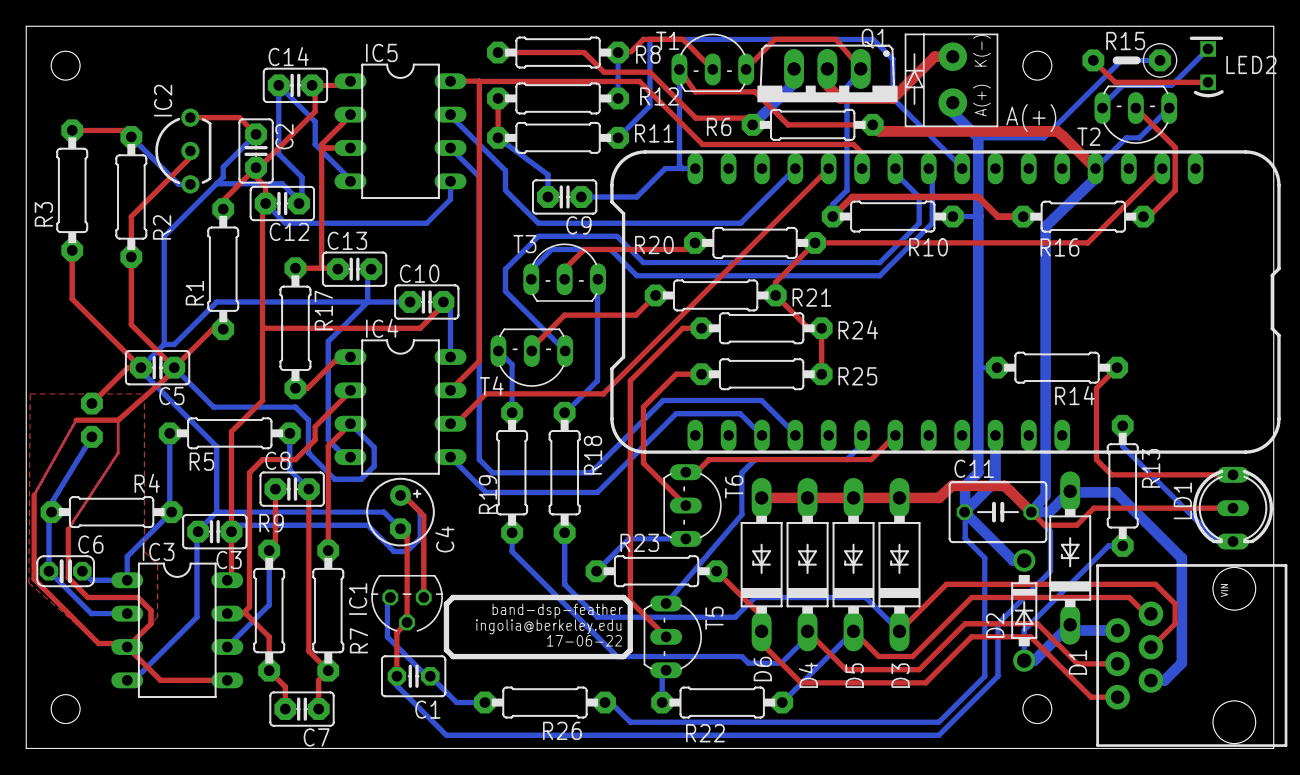
[picture p78: board band-dsp-feather.brd from above]

Board: 2 copper layers, 95.0 x 55.0 mm, 68 parts (1 on the bottom side), 47 nets.

Other parts of the board:
U$1, U$2, U$3, U$4: M2MOUNT
