ingolia-lab/turbidostat-development/nephelometer/circuitry/feather/band-motor-feather.brd

## EAGLE design nephelometer/circuitry/feather/band-motor-feather.brd (2017-06-30)

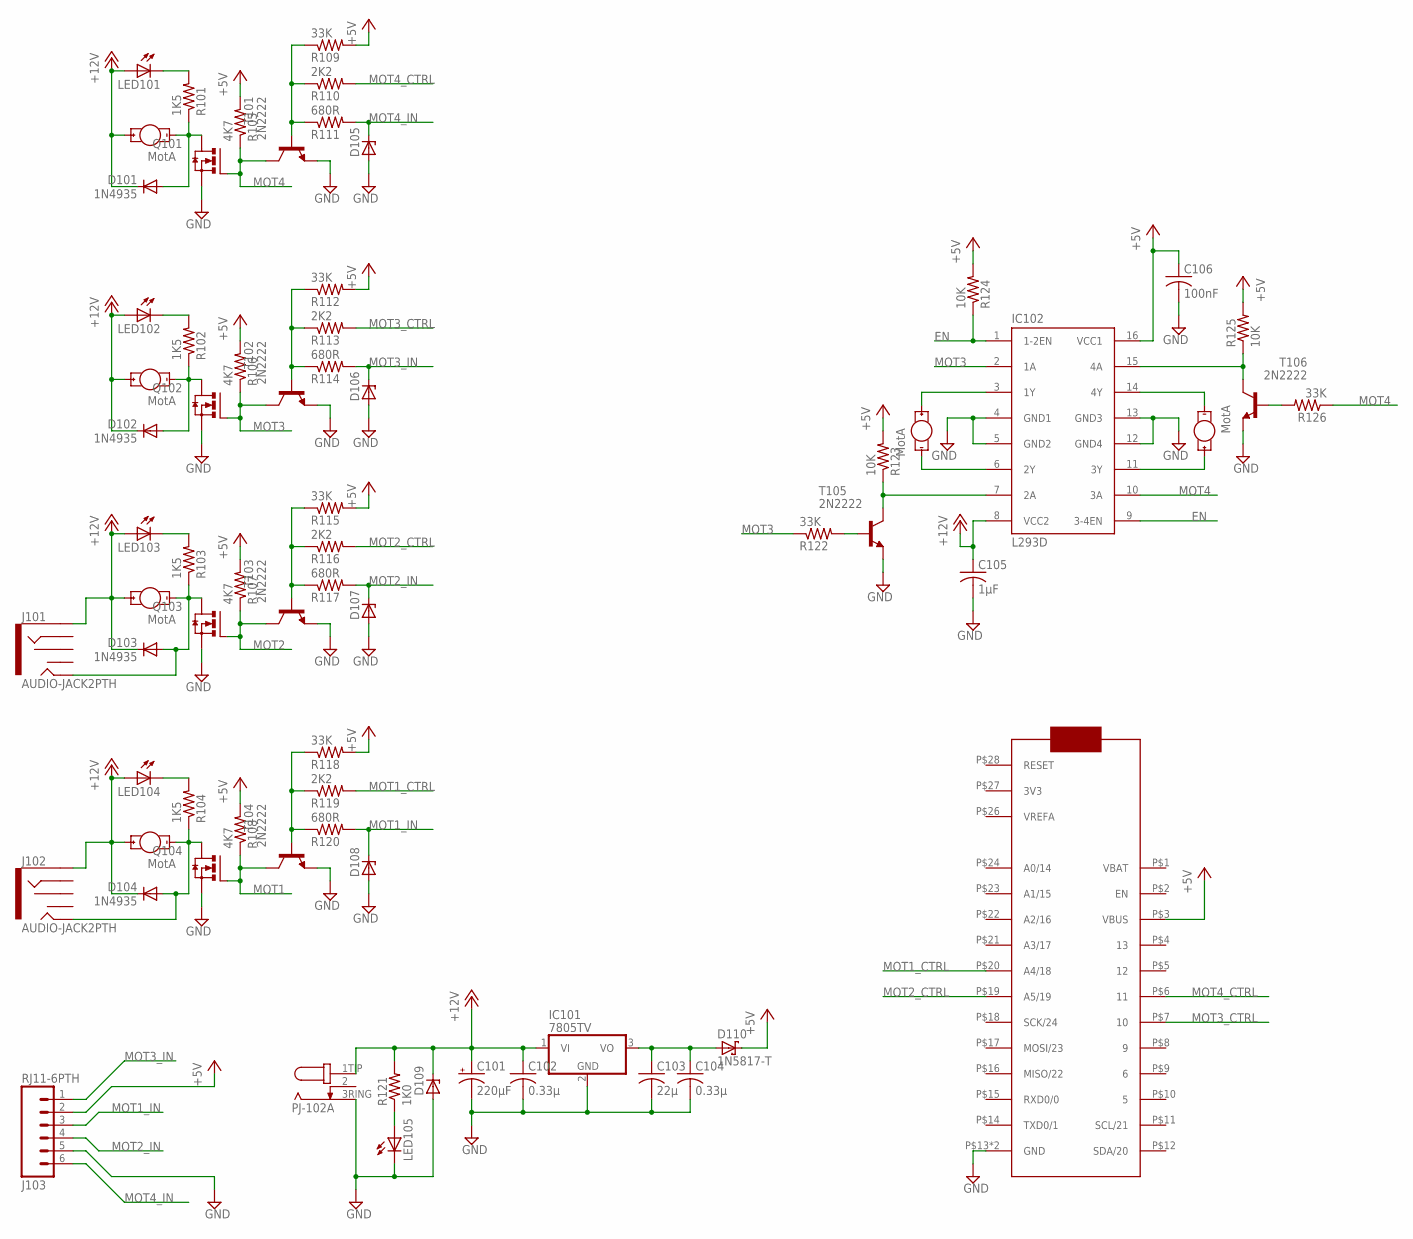
[picture p79: schematic band-motor-feather.sch]

Parts:
C101: 220µF; E3,5-8; DIGIKEY# P5166-ND
C102, C104: 0.33µ; C025-050X050; DIGIKEY# 445-5312-ND
C103: 22µ; C050-045X075; DIGIKEY# 445-8455-ND
C105: 1µF; C025-025X050; DIGIKEY# 445-5318-ND
C106: 100nF; C025-025X050; DIGIKEY# BC1084CT-ND
D101, D102, D103, D104: 1N4935; DO41-10; DIGIKEY# 1N4935FSCT-ND
D105, D106, D107, D108: ZENER-DIODEF126-10; F126Z10; DIGIKEY# SA5.0ALFCT-ND
D109: ZENER-DIODEF126-10; F126Z10; DIGIKEY# SA12ALFCT-ND
D110: 1N5817-T; DO41-7.6; DIGIKEY# 1N5817FSCT-ND
IC101: 7805TV; TO220V; DIGIKEY# LM7805CT-ND
IC102: L293D; DIL16; DIGIKEY# 296-9518-5-ND
IC103: FEATHER_M0; DIGIKEY# 2830-ND
J101, J102: AUDIO-JACK2PTH; AUDIO-JACK; DIGIKEY# CP1-3523N-ND
J103: RJ11-6PTH; RJ11-6; DIGIKEY# AE10383-ND
J104, J105, J106, J107, J109, J110: MotA; 1X02_3.5MM_MOT; DIGIKEY# ED2740-ND
J108: PJ-102A; DIGIKEY# CP-102A-ND
LED101, LED102, LED103, LED104: LED3MM; DIGIKEY# 754-1275-ND
LED105: LED5MM; DIGIKEY# 754-1735-ND
Q101, Q102, Q103, Q104: IRLB8721; TO220BV; DIGIKEY# IRLB8721PBF-ND
R101, R102, R103, R104: 1K5; 0207/10; DIGIKEY# CF14JT1K50CT-ND
R105, R106, R107, R108: 4K7; 0207/10; DIGIKEY# CF14JT4K70CT-ND
R109, R112, R115, R118, R122, R126: 33K; 0207/10; DIGIKEY# CF14JT33K0CT-ND
R110, R113, R116, R119: 2K2; 0207/10; DIGIKEY# CF14JT2K20CT-ND
R111, R114, R117, R120: 680R; 0207/10; DIGIKEY# CF14JT680RCT-ND
R121: 1K0; 0207/9; DIGIKEY# S1KHCT-ND
R123, R124, R125: 10K; 0207/10; DIGIKEY# CF14JT10K0CT-ND
T101, T102, T103, T104, T105, T106: 2N2222; TO92-EBC-OVAL; DIGIKEY# PN2222ATFCT-ND

Connections:
+5V: C106.1, D110.C, IC102.16 (VCC1), IC103.P$3 (VBUS), J103.2, R105.2, R106.2, R107.2, R108.2, R109.2, R112.2, R115.2, R118.2, R123.2, R124.2, R125.2
+12V: C101.+, C102.1, C105.1, D101.C, D102.C, D103.C, D104.C, D109.C, IC101.1 (VI), IC102.8 (VCC2), J101.SLEEVE, J102.SLEEVE, J104.1A (+), J105.1A (+), J106.1A (+), J107.1A (+), J108.1TIP (3TIP), LED101.A, LED102.A, LED103.A, LED104.A, R121.2
EN: IC102.1 (1-2EN), IC102.9 (3-4EN), R124.1
GND: C101.-, C102.2, C103.2, C104.2, C105.2, C106.2, D105.A, D106.A, D107.A, D108.A, D109.A, IC101.2 (GND), IC102.4 (GND1), IC102.5 (GND2), IC102.12 (GND4), IC102.13 (GND3), IC103.P$13 (GND), IC103.P$25 (GND), J103.5, J108.3RING (1RING), LED105.K (C), Q101.S, Q102.S, Q103.S, Q104.S, T101.E, T102.E, T103.E, T104.E, T105.E, T106.E
MOT1: Q104.G, R108.1, T104.C
MOT1_CTRL: IC103.P$20 (A4/18), R119.2
MOT1_IN: D108.C, J103.3, R120.2
MOT2: Q103.G, R107.1, T103.C
MOT2_CTRL: IC103.P$19 (A5/19), R116.2
MOT2_IN: D107.C, J103.4, R117.2
MOT3: IC102.2 (1A), Q102.G, R106.1, R122.1, T102.C
MOT3_CTRL: IC103.P$7 (10), R113.2
MOT3_IN: D106.C, J103.1, R114.2
MOT4: IC102.10 (3A), Q101.G, R105.1, R126.1, T101.C
MOT4_CTRL: IC103.P$6 (11), R110.2
MOT4_IN: D105.C, J103.6, R111.2
unnamed: LED105.A, R121.1
unnamed: C103.1, C104.1, D110.A, IC101.3 (VO)
unnamed: D103.A, J101.TIP, J106.2K (-), Q103.D, R103.1
unnamed: D104.A, J102.TIP, J107.2K (-), Q104.D, R104.1
unnamed: LED104.K (C), R104.2
unnamed: R118.1, R119.1, R120.1, T104.B
unnamed: LED103.K (C), R103.2
unnamed: R112.1, R113.1, R114.1, T102.B
unnamed: R109.1, R110.1, R111.1, T101.B
unnamed: R115.1, R116.1, R117.1, T103.B
unnamed: IC102.15 (4A), R125.1, T106.C
unnamed: R126.2, T106.B
unnamed: IC102.7 (2A), R123.1, T105.C
unnamed: R122.2, T105.B
unnamed: IC102.3 (1Y), J109.1A (+)
unnamed: IC102.6 (2Y), J109.2K (-)
unnamed: IC102.14 (4Y), J110.2K (-)
unnamed: IC102.11 (3Y), J110.1A (+)
unnamed: D102.A, J105.2K (-), Q102.D, R102.1
unnamed: LED102.K (C), R102.2
unnamed: D101.A, J104.2K (-), Q101.D, R101.1
unnamed: LED101.K (C), R101.2

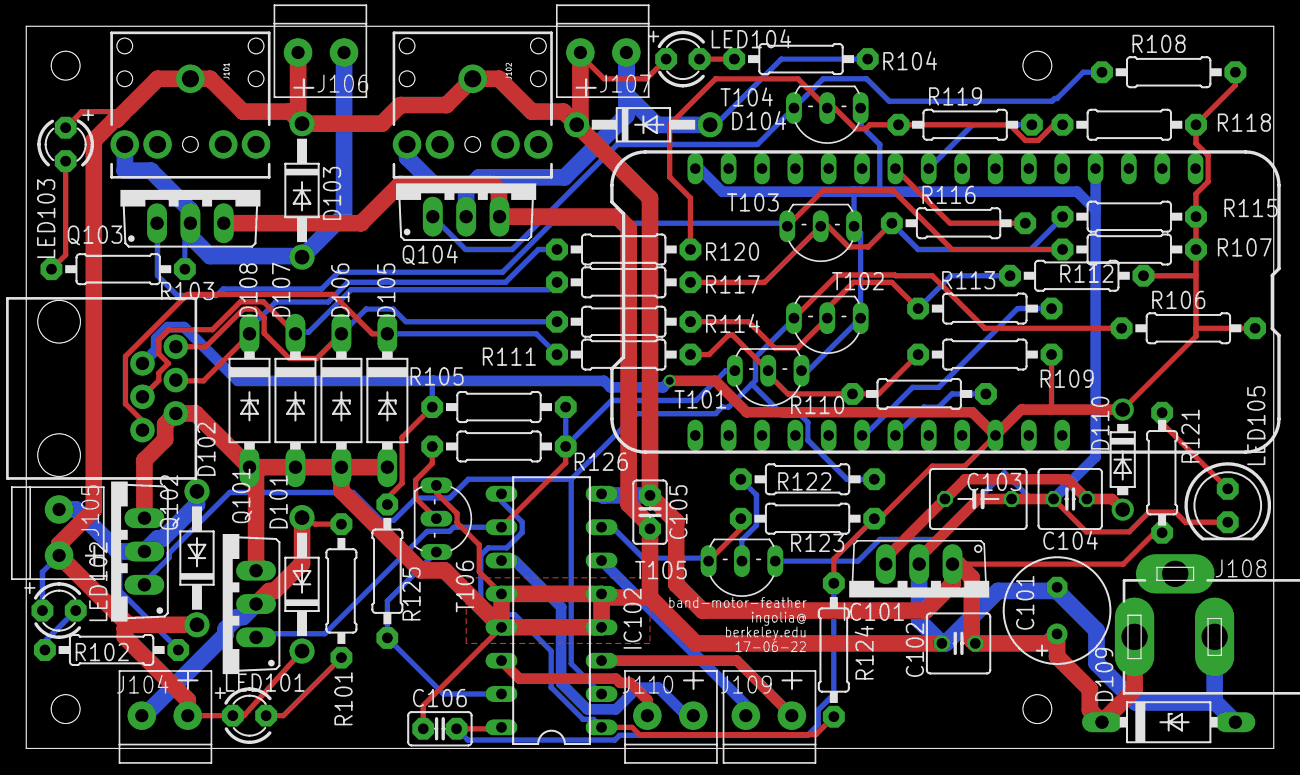
[picture p80: board band-motor-feather.brd from above]

Board: 2 copper layers, 95.0 x 55.0 mm, 74 parts (0 on the bottom side), 38 nets.

Other parts of the board:
U$3, U$4, U$6, U$7: M2MOUNT
