ingolia-lab/turbidostat-development/nephelometer/circuitry/teensy/band-motor-teensy.brd

## EAGLE design nephelometer/circuitry/teensy/band-motor-teensy.brd (2017-01-11)

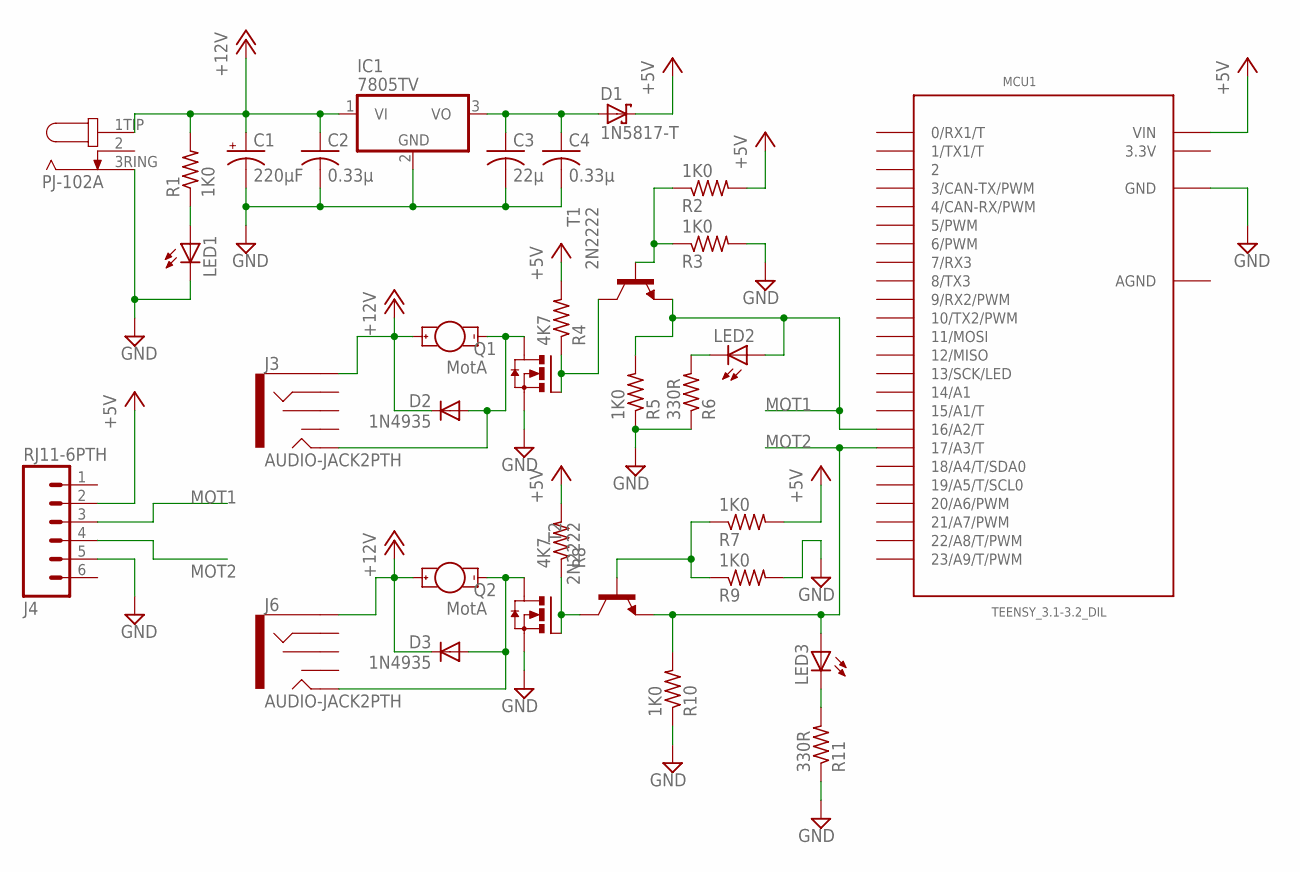
[picture p81: schematic band-motor-teensy.sch]

Parts:
C1: 220µF; E3,5-8; DIGIKEY# P5166-ND
C2, C4: 0.33µ; C025-050X050; DIGIKEY# 445-5312-ND
C3: 22µ; C050-045X075; DIGIKEY# 445-8455-ND
D1: 1N5817-T; DO41-7.6; DIGIKEY# 1N5817FSCT-ND
D2, D3: 1N4935; DO41-10; DIGIKEY# 1N4935FSCT-ND
IC1: 7805TV; TO220V; DIGIKEY# LM7805CT-ND
J1: PJ-102A; DIGIKEY# CP-102A-ND
J2, J5: MotA; 1X02_3.5MM_MOT; DIGIKEY# ED2740-ND
J3, J6: AUDIO-JACK2PTH; AUDIO-JACK; DIGIKEY# CP1-3523N-ND
J4: RJ11-6PTH; RJ11-6; DIGIKEY# AE10383-ND
LED1: LED5MM; DIGIKEY# 754-1735-ND
LED2, LED3: LED3MM; DIGIKEY# 754-1275-ND
MCU1: TEENSY_3.1-3.2_DIL; TEENSY_3.0-3.2&LC_DIL; DIGIKEY# SAM1198-14-ND
Q1, Q2: IRLB8721; TO220BV; DIGIKEY# IRLB8721PBF-ND
R1: 1K0; 0207/9; DIGIKEY# S1KHCT-ND
R2, R3, R5, R7, R9, R10: 1K0; 0207/10; DIGIKEY# S1KHCT-ND
R4, R8: 4K7; 0207/10; DIGIKEY# CF14JT4K70CT-ND
R6, R11: 330R; 0207/10; DIGIKEY# CF14JT330RCT-ND
T1, T2: 2N2222; TO92-EBC-OVAL; DIGIKEY# PN2222ATFCT-ND

Connections:
3.3V: MCU1.3.3V
+5V: D1.C, J4.2, MCU1.VIN, R2.2, R4.2, R7.2, R8.2
+12V: C1.+, C2.1, D2.C, D3.C, IC1.1 (VI), J1.1TIP (3TIP), J2.1A (+), J3.SLEEVE, J5.1A (+), J6.SLEEVE, R1.2
AGND: MCU1.AGND
GND: C1.-, C2.2, C3.2, C4.2, IC1.2 (GND), J1.3RING (1RING), J4.5, LED1.K (C), MCU1.GND, Q1.S, Q2.S, R3.2, R5.1, R6.1, R9.2, R10.1, R11.1
MOT1: J4.3, LED2.A, MCU1.16/A2 (16/A2/T), R5.2, T1.E
MOT2: J4.4, LED3.A, MCU1.17/A3 (17/A3/T), R10.2, T2.E
unnamed: LED1.A, R1.1
unnamed: C3.1, C4.1, D1.A, IC1.3 (VO)
unnamed: D3.A, J5.2K (-), J6.TIP, Q2.D
unnamed: D2.A, J2.2K (-), J3.TIP, Q1.D
unnamed: LED2.K (C), R6.2
unnamed: R2.1, R3.1, T1.B
unnamed: R7.1, R9.1, T2.B
unnamed: Q1.G, R4.1, T1.C
unnamed: Q2.G, R8.1, T2.C
unnamed: LED3.K (C), R11.2

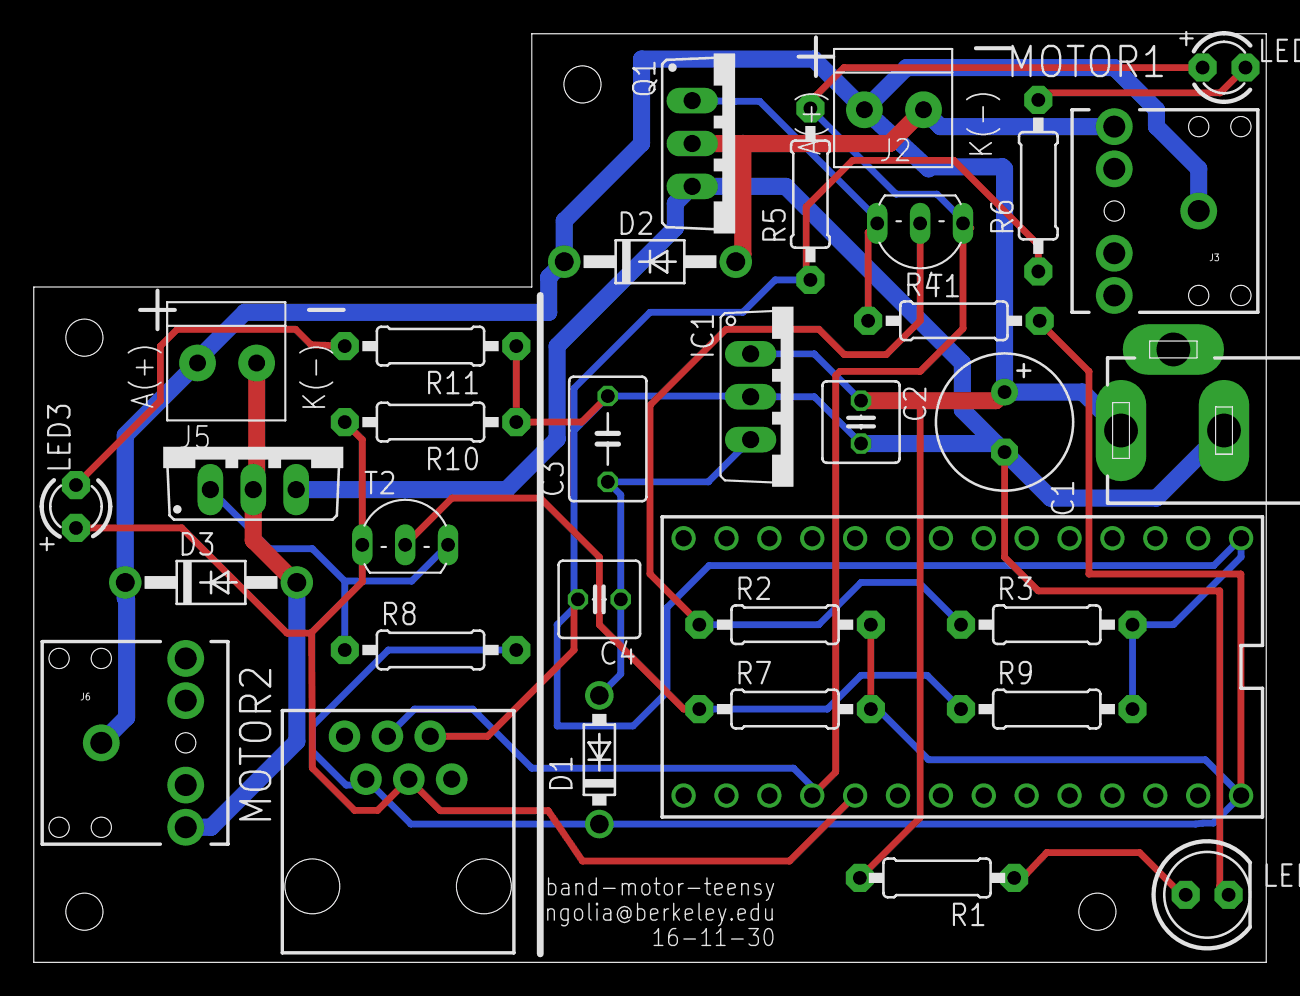
[picture p82: board band-motor-teensy.brd from above]

Board: 2 copper layers, 73.0 x 55.0 mm, 37 parts (0 on the bottom side), 15 nets.

Other parts of the board:
U$3, U$4, U$6, U$7: M2MOUNT
