ingolia-lab/turbidostat-development/nephelometer/circuitry/teensy/band-dsp-teensy.brd

## EAGLE design nephelometer/circuitry/teensy/band-dsp-teensy.brd (2017-06-03)

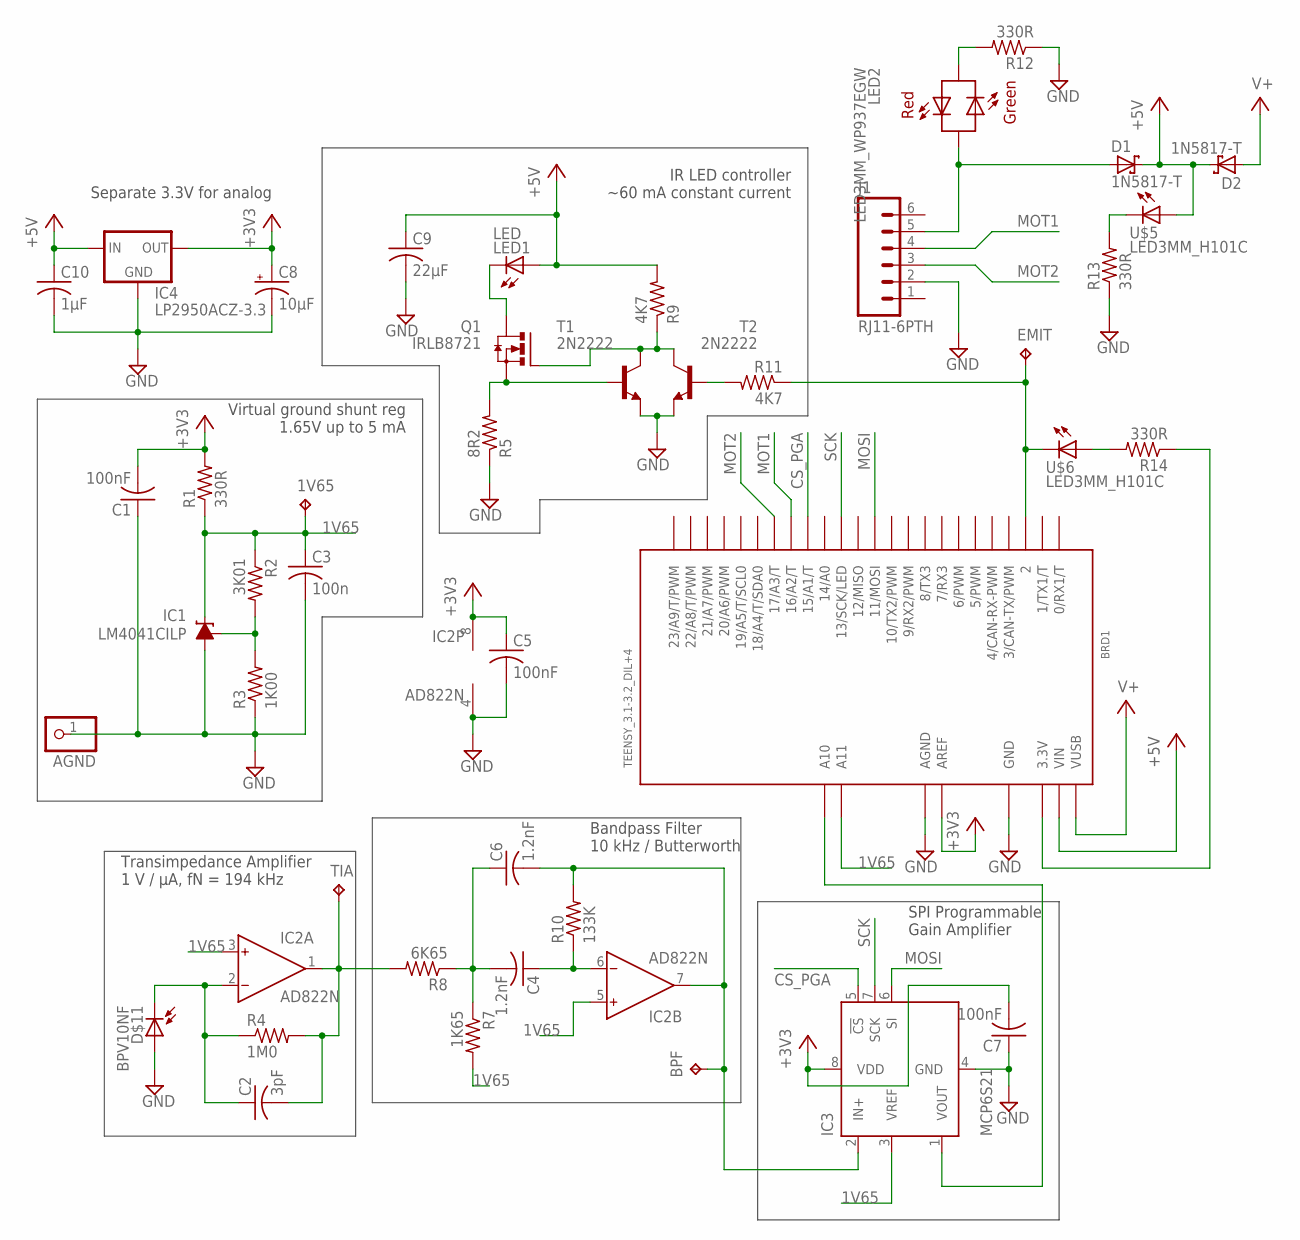
[picture p83: schematic band-dsp-teensy.sch]

Parts:
1V65: TPTP10R; TP10R
AGND: PINHD-1X1; 1X01
BPF: TPTP10R; TP10R
BRD1: TEENSY_3.1-3.2_DIL+4; TEENSY_3.0-3.2&LC_DIL+4; DIGIKEY# 1568-1231-ND
C1, C5, C7: 100nF; C025-025X050; DIGIKEY# BC1084CT-ND
C2: 3pF; C025-024X044; DIGIKEY# 445-8377-ND
C3: 100n; C025-025X050; DIGIKEY# BC1084CT-ND
C4, C6: 1.2nF; C025-025X050; DIGIKEY# BC1026CT-ND
C8: 10µF; E2,5-5; DIGIKEY# 478-8042-1-ND
C9: 22µF; C050-045X075; DIGIKEY# 445-8455-ND
C10: 1µF; C025-030X050; DIGIKEY# 445-5318-ND
D1, D2: 1N5817-T; DO41-7.6; DIGIKEY# 1N5817FSCT-ND
D$11: BPV10NF; LED5MM; DIGIKEY# 751-1002-ND
EMIT: TPPAD1-13; P1-13
IC1: LM4041CILP; LP_O-PBCY-W3; DIGIKEY# 296-22173-1-ND
IC2: AD822N; DIL08; DIGIKEY# AD823ANZ-ND
IC3: MCP6S21; DIL08; DIGIKEY# MCP6S91-E/P-ND
IC4: LP2950ACZ-3.3; TO92; DIGIKEY# LP2950ACZ-3.3/NOPB-ND
J1: RJ11-6PTH; RJ11-6; DIGIKEY# AE10383-ND
LED1: LED; 1X02_3.5MM; DIGIKEY# 475-3002-ND
LED2: LED3MM_WP937EGW; LED3MM_H101C_BICOL; DIGIKEY# 754-1751-ND
Q1: IRLB8721; TO220BH; DIGIKEY# IRLB8721PBF-ND
R1, R12, R13: 330R; 0207/9; DIGIKEY# CF14JT330RCT-ND
R2: 3K01; 0207/9; DIGIKEY# RNF14FTD3K01CT-ND
R3: 1K00; 0207/9; DIGIKEY# RNF14FTD1K00CT-ND
R4: 1M0; 0207/9; DIGIKEY# RNV14FAL1M00CT-ND
R5: 8R2; 0207/9; DIGIKEY# S8.2HCT-ND
R7: 1K65; 0207/9; DIGIKEY# 1.65KXBK-ND
R8: 6K65; 0207/9; DIGIKEY# 6.65KXBK-ND
R9, R11: 4K7; 0207/9; DIGIKEY# CF14JT4K70CT-ND
R10: 133K; 0207/9; DIGIKEY# 133KXBK-ND
R14: 330R; 0207/9; DIGIKEY# CF14JT150RCT-ND
T1, T2: 2N2222; TO92-EBC-OVAL; DIGIKEY# PN2222ATFCT-ND
TIA: TPTP10R; TP10R
U$5: LED3MM_H101C; DIGIKEY# 754-1595-ND
U$6: LED3MM_H101C; DIGIKEY# 754-1727-ND

Connections:
1V65: 1V65.TP, BRD1.A11, C3.1, IC1.2 (C), IC2.3 (IN+), IC2.5 (IN+), IC3.3 (VREF), R1.1, R2.1, R7.2
+3V3: BRD1.AREF, C1.2, C5.1, C7.2, C8.+, IC2.8 (V+), IC3.8 (VDD), IC4.1 (OUT), R1.2
+5V: BRD1.VIN, C9.1, C10.1, D1.C, D2.C, IC4.3 (IN), LED1.1A (A), R9.2, U$5.A
CS_PGA: BRD1.15/A1 (15/A1/T), IC3.5 (!CS)
GND: AGND.1, BRD1.AGND, BRD1.GND, C1.1, C3.2, C5.2, C7.1, C8.-, C9.2, C10.2, D$11.A, IC1.3 (A), IC2.4 (V-), IC3.4 (GND), IC4.2 (GND), J1.2, R3.1, R5.1, R12.1, R13.1, T1.E, T2.E
LEDCTRL: R11.2, T2.B
MOSI: BRD1.11 (11/MOSI), IC3.6 (SI)
MOT1: BRD1.16/A2 (16/A2/T), J1.4
MOT2: BRD1.17/A3 (17/A3/T), J1.3
unnamed: C2.1, D$11.K, IC2.2 (IN-), R4.1
unnamed: BRD1.3.3V, R14.1
unnamed: C4.2, C6.1, R7.1, R8.1
unnamed: BRD1.A10, IC3.1 (VOUT)
unnamed: BRD1.2, EMIT.TP, R11.1, U$6.K
unnamed: BPF.TP, C6.2, IC2.7 (OUT), IC3.2 (IN+), R10.2
unnamed: R13.2, U$5.K
unnamed: Q1.G, R9.1, T1.C, T2.C
unnamed: C4.1, IC2.6 (IN-), R10.1
unnamed: D1.A, J1.5, LED2.SHORT (GA)
unnamed: R14.2, U$6.A
unnamed: LED2.LONG (GK), R12.2
unnamed: Q1.S, R5.2, T1.B
unnamed: LED1.2K (K), Q1.D
unnamed: C2.2, IC2.1 (OUT), R4.2, R8.2, TIA.TP
unnamed: IC1.1 (FB), R2.2, R3.2
SCK: BRD1.13 (13/SCK/LED), IC3.7 (SCK)
V+: BRD1.VUSB, D2.A

Notes on the sheet:
Transimpedance Amplifier 1 V / µA, fN = 194 kHz
Bandpass Filter 10 kHz / Butterworth
Virtual ground shunt reg 1.65V up to 5 mA
IR LED controller ~60 mA constant current
SPI Programmable Gain Amplifier
Separate 3.3V for analog
