ingolia-lab/turbidostat-development/nephelometer/circuitry/teensy/band-dsp-teensy.brd

## EAGLE design nephelometer/circuitry/teensy/band-dsp-teensy.brd (continued)

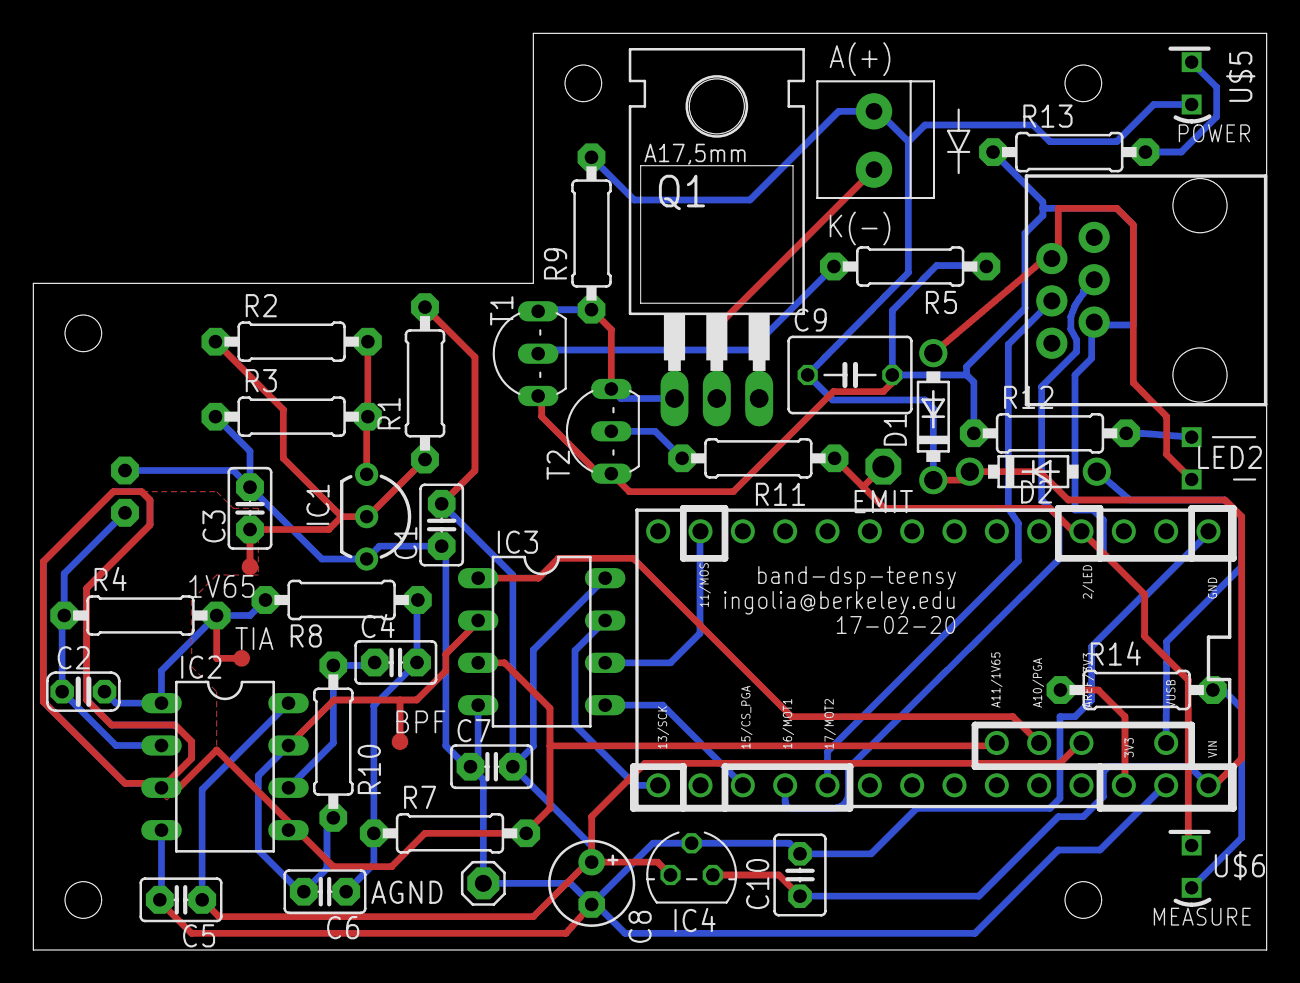
[picture p84: board band-dsp-teensy.brd from above]

Board: 2 copper layers, 74.0 x 55.0 mm, 49 parts (1 on the bottom side), 27 nets.

Other parts of the board:
U$1, U$2, U$3, U$4, U$7: M2MOUNT
