ingolia-lab/turbidostat-development/nephelometer/circuitry/dsp-micro/band-dsp-micro.brd

## EAGLE design nephelometer/circuitry/dsp-micro/band-dsp-micro.brd (2017-06-03)

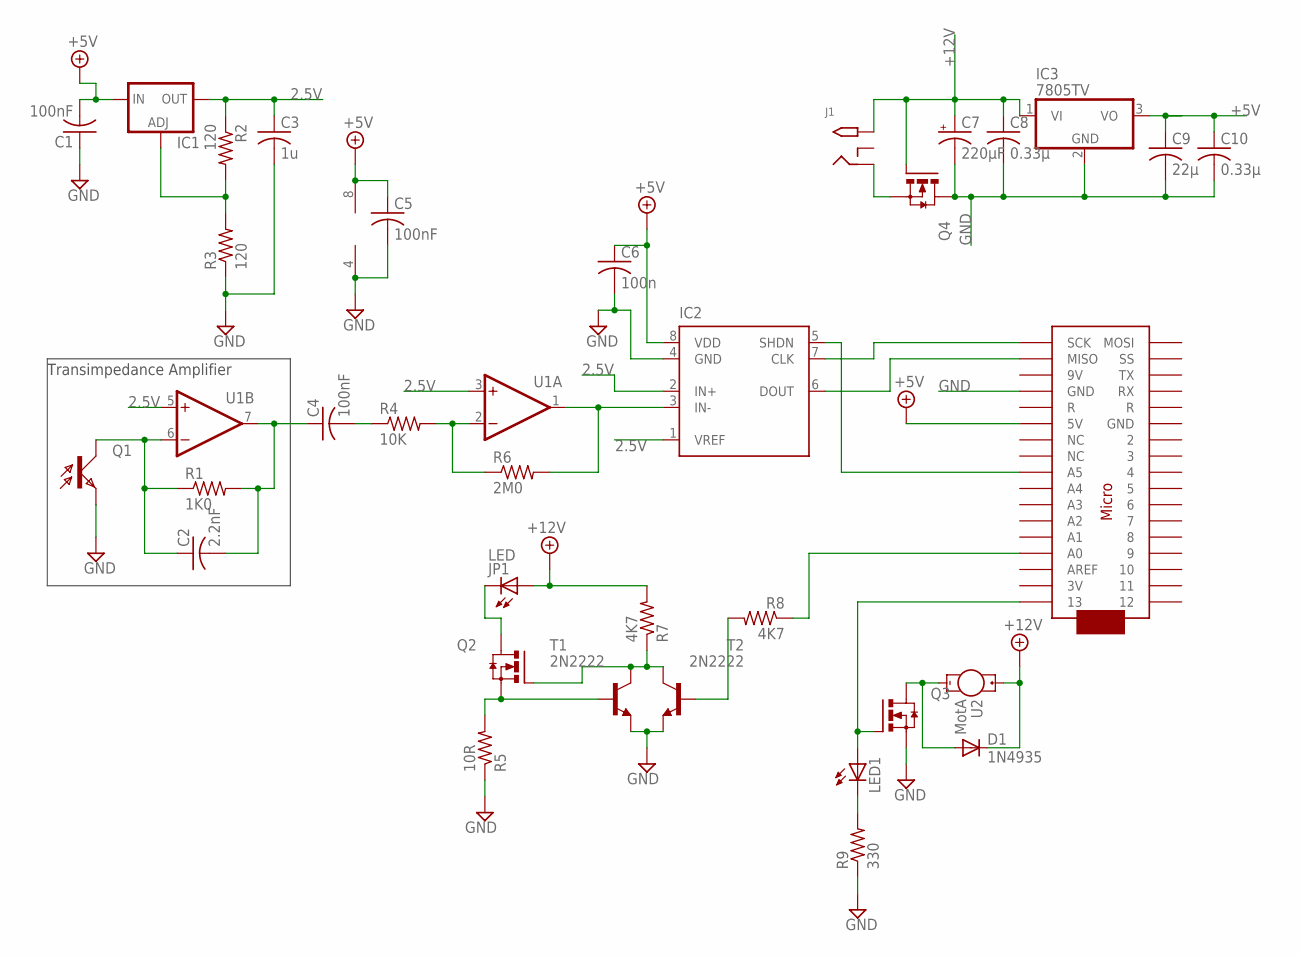
[picture p85: schematic band-dsp-micro.sch]

Parts:
C1, C5: 100nF; C025-025X050; DIGIKEY# BC1084CT-ND
C2: 2.2nF; C025-024X044; DIGIKEY# BC1029CT-ND
C3: 1u; C050-024X044; DIGIKEY# 445-8614-ND
C4: 100nF; C025-060X050; DIGIKEY# 445-8325-ND
C6: 100n; C025-025X050; DIGIKEY# BC1084CT-ND
C7: 220µF; E3,5-8; DIGIKEY# P5166-ND
C8, C10: 0.33µ; C025-050X050; DIGIKEY# 445-5312-ND
C9: 22µ; C050-045X075; DIGIKEY# 445-8455-ND
D1: 1N4935; DO41-10; DIGIKEY# 1N4935FSCT-ND
IC1: LM317L; 317L; DIGIKEY# 296-33312-5-ND
IC2: MCP3301; DIL08; DIGIKEY# MCP3301-BI/P-ND
IC3: 7805TV; TO220V; DIGIKEY# LM7805CT-ND
J1: 2.1MMJACKTHM; PJ-102A; DIGIKEY# CP-102A-ND
JP1: LED; 1X02_SCREW; DIGIKEY# 475-3002-ND
LED1: LED3MM; DIGIKEY# 160-1139-ND
Q1: LTR-4206; 3MM_LED; DIGIKEY# 160-1030-ND
Q2, Q3, Q4: IRLB8721; TO220BV; DIGIKEY# IRLB8721PBF-ND
R1: 1K0; 0204/5; DIGIKEY# S1KCACT-ND
R2, R3: 120; 0204V; DIGIKEY# S120CACT-ND
R4: 10K; 0204/5; DIGIKEY# S10KCACT-ND
R5: 10R; 0204V; DIGIKEY# PPC10W-1CT-ND
R6: 2M0; 0309V; DIGIKEY# RNV14FAL2M00TB-ND
R7, R8: 4K7; 0204V; DIGIKEY# S4.7KQCT-ND
R9: 330; 0204V; DIGIKEY# CF14JT330RCT-ND
T1, T2: 2N2222; TO92-EBC-OVAL; DIGIKEY# PN2222ATFCT-ND
U1: LMC6482; DIL08; DIGIKEY# LMC6482AIN/NOPB-ND
U2: MotA; 1X02_SCREW; DIGIKEY# SC1455-ND
U3: ARDUINOMICRO; DIGIKEY# 1050-1066-ND

Connections:
2.5V: C3.1, IC1.2 (OUT), IC2.1 (VREF), IC2.2 (IN+), R2.1, U1.3 (+IN), U1.5 (+IN)
+5V: C1.2, C5.1, C6.1, C9.1, C10.1, IC1.3 (IN), IC2.8 (VDD), IC3.3 (VO), U1.8 (V+), U3.P$23 (5V)
+12V: C7.+, C8.1, D1.C, IC3.1 (VI), J1.TIP, JP1.1/POS (A), Q4.G, R7.2, U2.1/POS (+)
GND: C1.1, C3.2, C5.2, C6.2, C7.-, C8.2, C9.2, C10.2, IC2.4 (GND), IC3.2 (GND), Q1.A (E), Q3.S, Q4.D, R3.1, R5.1, R9.1, T1.E, T2.E, U1.4 (V-), U3.P$12 (GND)
LEDCTRL: R8.2, T2.B
unnamed: C2.1, Q1.K (C), R1.1, U1.6 (-IN)
unnamed: C4.2, R4.1
unnamed: D1.A, Q3.D, U2.2 (-)
unnamed: IC2.6 (DOUT), U3.P$19 (MISO)
unnamed: R8.1, U3.P$31 (A0)
unnamed: IC2.7 (CLK), U3.P$18 (SCK)
unnamed: IC2.5 (SHDN), U3.P$26 (A5)
unnamed: Q2.G, R7.1, T1.C, T2.C
unnamed: Q2.S, R5.2, T1.B
unnamed: LED1.K (C), R9.2
unnamed: JP1.2 (K), Q2.D
unnamed: LED1.A, Q3.G, U3.P$34 (13)
unnamed: C2.2, C4.1, R1.2, U1.7 (OUT)
unnamed: R4.2, R6.1, U1.2 (-IN)
unnamed: IC2.3 (IN-), R6.2, U1.1 (OUT)
unnamed: IC1.1 (ADJ), R2.2, R3.2
unnamed: J1.RING, Q4.S

Notes on the sheet:
Transimpedance Amplifier

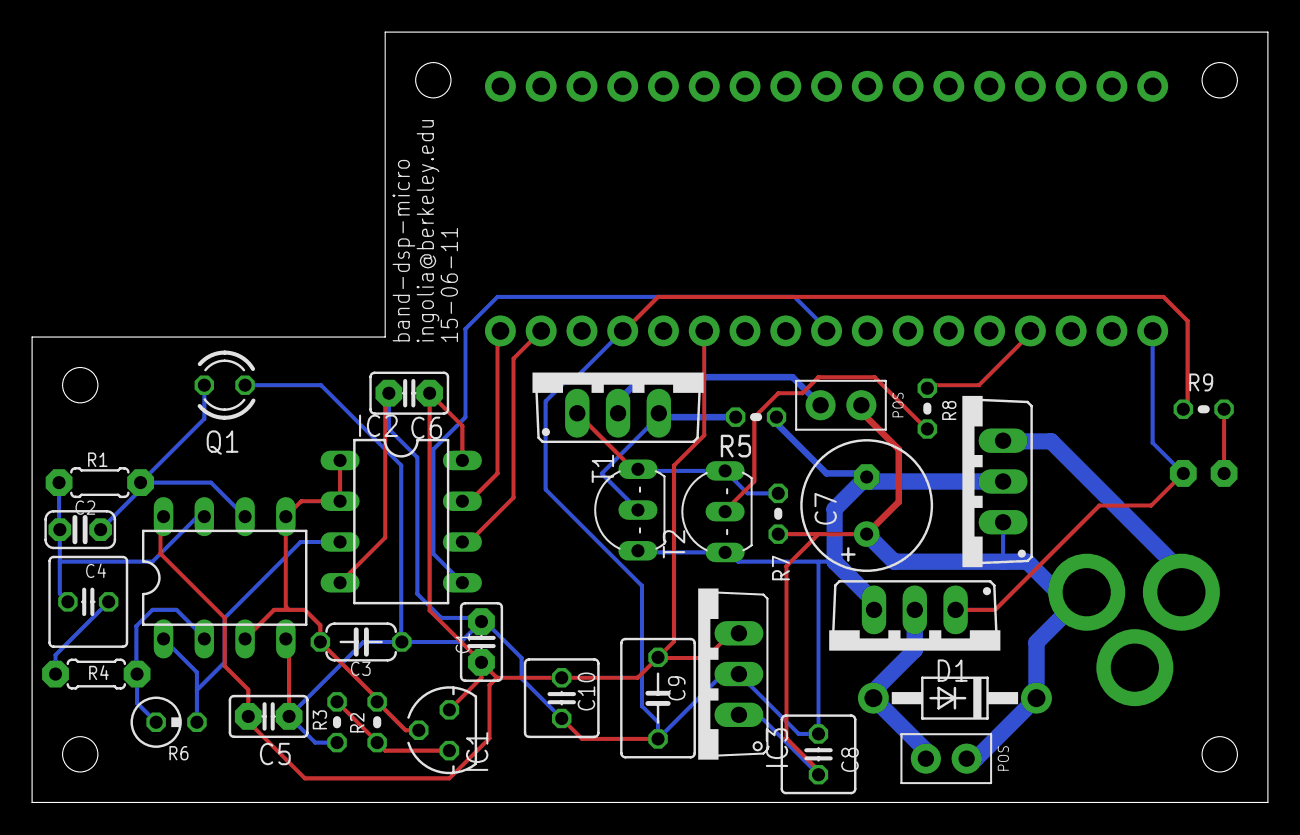
[picture p86: board band-dsp-micro.brd from above]

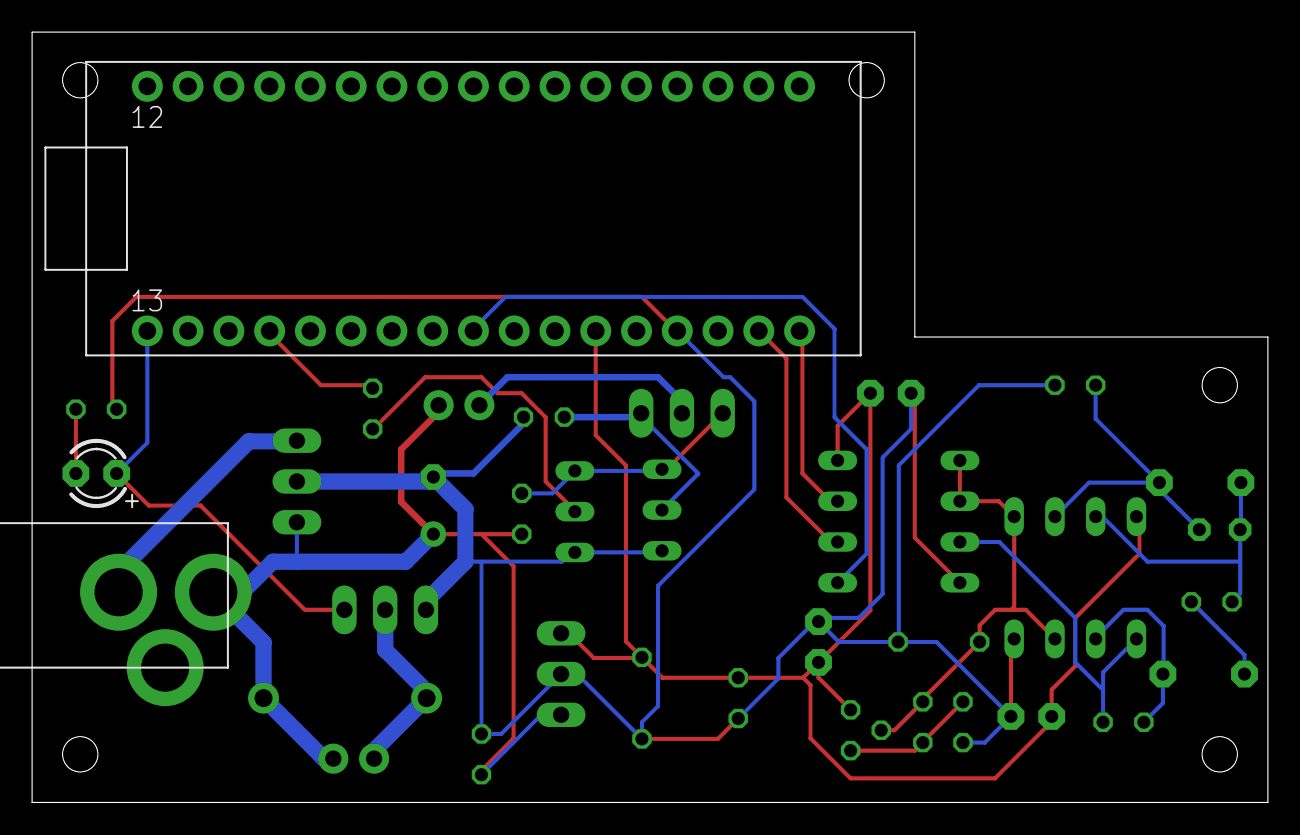
[picture p87: board band-dsp-micro.brd from below]

Board: 2 copper layers, 77.0 x 48.0 mm, 40 parts (3 on the bottom side), 22 nets.

Other parts of the board:
U$1, U$2, U$3, U$4, U$7: M2MOUNT
