ingolia-lab/turbidostat-development/nephelometer/circuitry/micro-standalone/band-psd-micro-standalone.brd

## EAGLE design nephelometer/circuitry/micro-standalone/band-psd-micro-standalone.brd (2015-02-03)

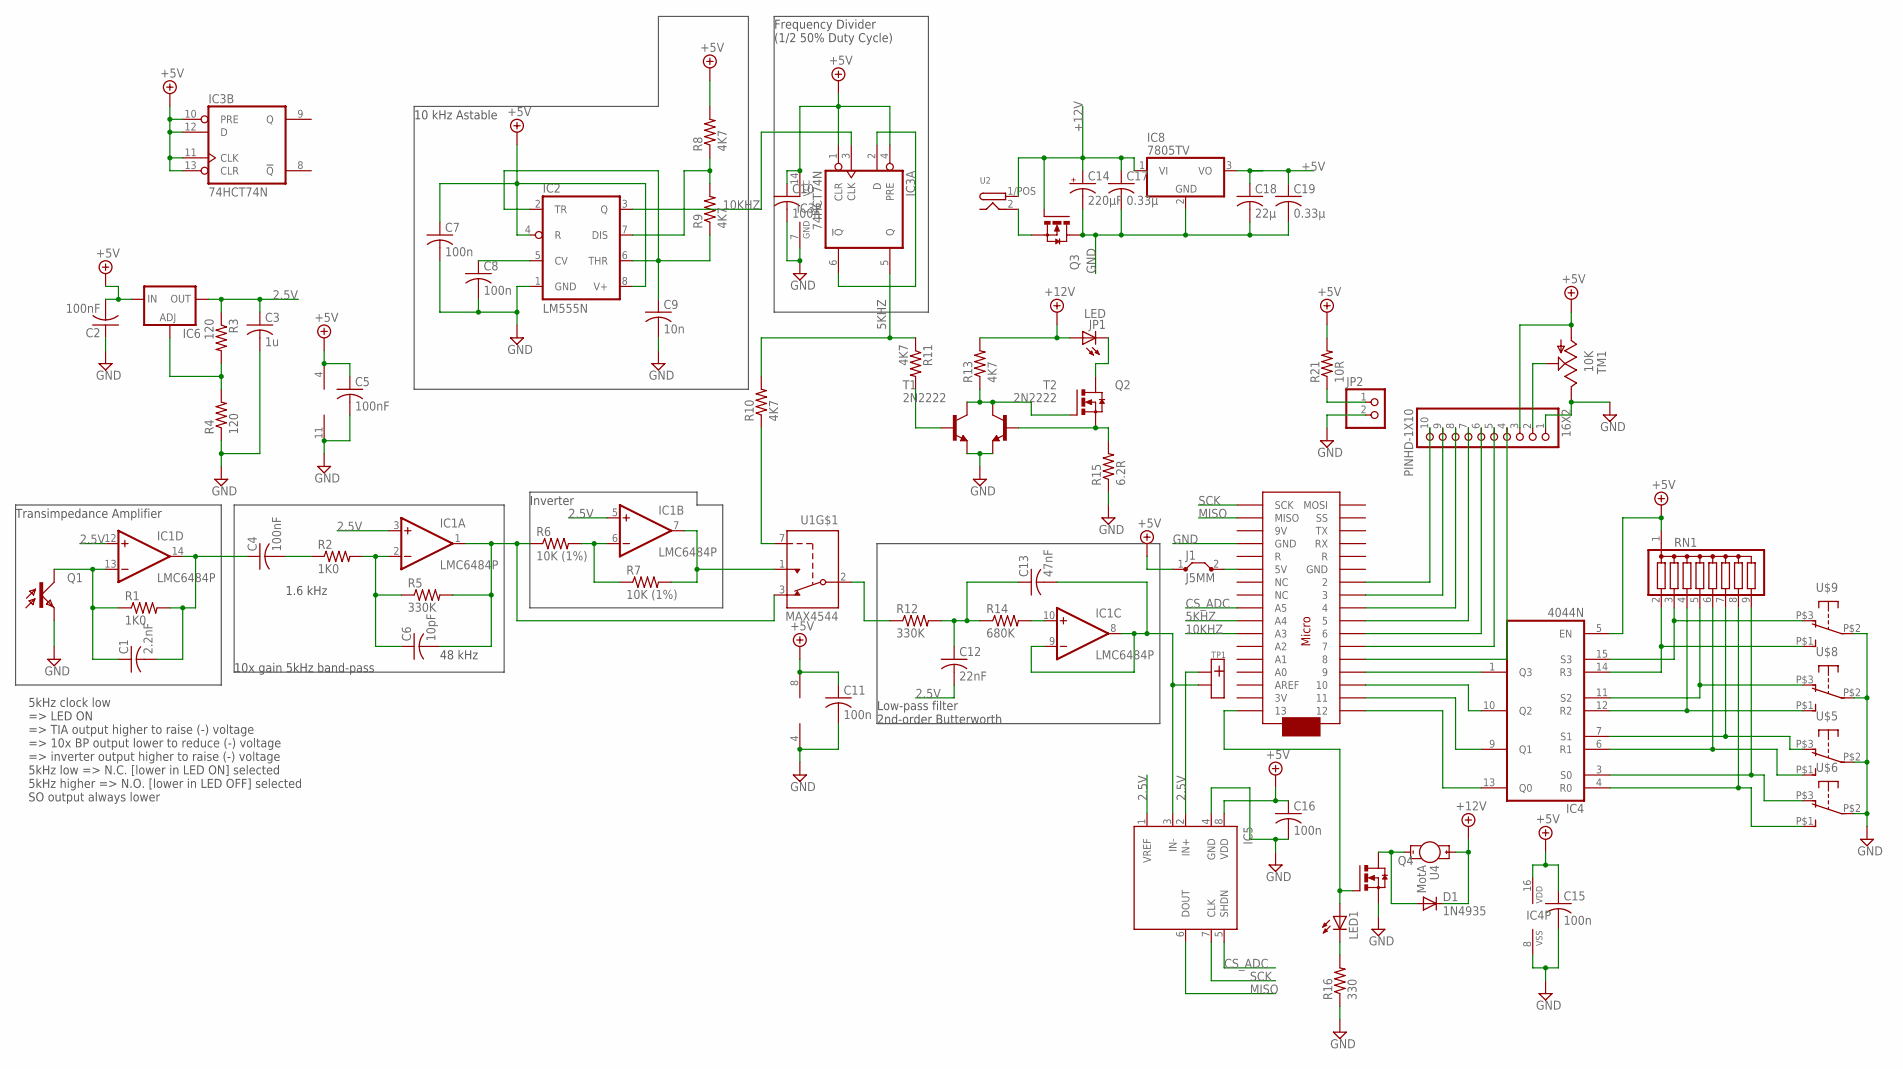
[picture p88: schematic band-psd-micro-standalone.sch]

Parts:
16X2: PINHD-1X10; 1X10-BIG
C1: 2.2nF; C025-024X044; DIGIKEY# BC1029CT-ND
C2, C5: 100nF; C025-025X050; DIGIKEY# BC1084CT-ND
C3: 1u; C050-024X044; DIGIKEY# 445-8614-ND
C4: 100nF; C025-060X050; DIGIKEY# 445-8325-ND
C6: 10pF; C025-024X044; DIGIKEY# BC1001CT-ND
C7, C8, C10, C11, C15, C16: 100n; C025-025X050; DIGIKEY# BC1084CT-ND
C9: 10n; C025-025X050; DIGIKEY# 445-8384-ND
C12: 22nF; C025-024X044; DIGIKEY# 445-8280-ND
C13: 47nF; C025-040X050; DIGIKEY# 445-8327-ND
C14: 220µF; E3,5-8; DIGIKEY# P5166-ND
C17, C19: 0.33µ; C025-050X050; DIGIKEY# 445-5312-ND
C18: 22µ; C050-045X075; DIGIKEY# 445-8455-ND
D1: 1N4935; DO41-10; DIGIKEY# 1N4935FSCT-ND
IC1: LMC6484P; DIL14; DIGIKEY# LMC6484AIN/NOPB-ND
IC2: LM555N; DIL08; DIGIKEY# LM555CNFS-ND
IC3: 74HCT74N; DIL14; DIGIKEY# 296-1625-5-ND
IC4: 4044N; DIL16; DIGIKEY# 296-2051-5-ND
IC5: MCP3301; DIL08; DIGIKEY# MCP3301-BI/P-ND
IC6: LM317L; 317L; DIGIKEY# 296-33312-5-ND
IC8: 7805TV; TO220V; DIGIKEY# LM7805CT-ND
J1: J5MM; 05; DIGIKEY# 0.0EBK-ND
JP1: LED; 1X02_SCREW; DIGIKEY# 475-3002-ND
JP2: PINHD-1X2; 1X02
LED1: LED3MM; DIGIKEY# 160-1139-ND
Q1: LTR-4206; 3MM_LED; DIGIKEY# 160-1030-ND
Q2, Q3, Q4: IRLB8721; TO220BV; DIGIKEY# IRLB8721PBF-ND
R1, R2: 1K0; 0204/5; DIGIKEY# S1KCACT-ND
R3, R4: 120; 0204V; DIGIKEY# S120CACT-ND
R5: 330K; 0309V; DIGIKEY# RNV14FAL330KCT-ND
R6, R7: 10K (1%); 0204/5; DIGIKEY# S10KCACT-ND
R8, R9: 4K7; 0204V; DIGIKEY# S4.7KCACT-ND
R10, R11, R13: 4K7; 0204V; DIGIKEY# S4.7KQCT-ND
R12: 330K; 0204V; DIGIKEY# RNV14FAL330KCT-ND
R14: 680K; 0204V; DIGIKEY# S680KCACT-ND
R15: 6.2R; 0204V; DIGIKEY# PPC6.2W-1CT-ND
R16: 330; 0204V; DIGIKEY# CF14JT330RCT-ND
R21: 10R; 0204V
RN1: G08R; SIL9; DIGIKEY# 4609X-101-103LF-ND
T1, T2: 2N2222; TO92-EBC-OVAL; DIGIKEY# PN2222ATFCT-ND
TM1: 10K; B25P; DIGIKEY# 3386P-103LF-ND
TP1: TEST_POINT; 1X02_SCREW
U1: MAX4544; DIL08; DIGIKEY# MAX4544CPA+-ND
U2: DC-IN-PANEL-NODETECT; 1X02_SCREW; DIGIKEY# CP-5-ND
U3: ARDUINOMICRO; DIGIKEY# 1050-1066-ND
U4: MotA; 1X02_SCREW; DIGIKEY# SC1455-ND
U$5, U$6, U$8, U$9: APE1F-5M-10-Z; APE1F-5M-10Z; DIGIKEY# 563-1183-ND

Connections:
2.5V: C3.1, C12.2, IC1.3 (+IN), IC1.5 (+IN), IC1.12 (+IN), IC5.1 (VREF), IC5.2 (IN+), IC6.2 (OUT), R3.1, TP1.1/POS (+)
5KHZ: IC3.5 (Q), R10.2, R11.1, U3.P$27 (A4)
10KHZ: IC2.3 (Q), IC3.3 (CLK), U3.P$28 (A3)
+5V: 16X2.3, C2.2, C5.1, C7.1, C10.1, C11.1, C15.1, C16.1, C18.1, C19.1, IC1.4 (V+), IC2.4 (R), IC2.8 (V+), IC3.1 (CLR), IC3.4 (PRE), IC3.10 (PRE), IC3.11 (CLK), IC3.12 (D), IC3.13 (CLR), IC3.14 (VCC), IC4.5 (EN), IC4.16 (VDD), IC5.8 (VDD), IC6.3 (IN), IC8.3 (VO), J1.1, R8.2, R21.2, RN1.1, TM1.A, U1.8 (V+)
+12V: C14.+, C17.1, D1.C, IC8.1 (VI), JP1.1/POS (A), Q3.G, R13.2, U2.1/POS (PWR), U4.1/POS (+)
CS_ADC: IC5.5 (SHDN), U3.P$26 (A5)
GND: 16X2.1, C2.1, C3.2, C5.2, C7.2, C8.2, C9.2, C10.2, C11.2, C14.-, C15.2, C16.2, C17.2, C18.2, C19.2, IC1.11 (V-), IC2.1 (GND), IC3.7 (GND), IC4.8 (VSS), IC5.4 (GND), IC8.2 (GND), JP2.2, Q1.A (E), Q3.D, Q4.S, R4.1, R15.1, R16.1, T1.E, T2.E, TM1.E, U1.4 (V-), U3.P$12 (GND), U$5.P$2 (COM), U$6.P$2 (COM), U$8.P$2 (COM), U$9.P$2 (COM)
LEDCTRL: R11.2, T1.B
MISO: IC5.6 (DOUT), U3.P$19 (MISO)
unnamed: C1.1, IC1.13 (-IN), Q1.K (C), R1.1
unnamed: C4.2, R2.1
unnamed: D1.A, Q4.D, U4.2 (-)
unnamed: IC1.6 (-IN), R6.2, R7.1
unnamed: IC1.7 (OUT), R7.2, U1.1 (NO)
unnamed: R12.1, U1.2 (COM)
unnamed: IC1.10 (+IN), R14.2
unnamed: Q2.G, R13.1, T1.C, T2.C
unnamed: C9.1, IC2.2 (TR), IC2.6 (THR), R9.1
unnamed: C8.1, IC2.5 (CV)
unnamed: IC4.9 (Q1), U3.P$2 (11)
unnamed: IC3.2 (D), IC3.6 (!Q)
unnamed: IC2.7 (DIS), R8.1, R9.2
unnamed: Q2.S, R15.2, T2.B
unnamed: IC4.13 (Q0), U3.P$1 (12)
unnamed: LED1.K (C), R16.2
unnamed: JP1.2 (K), Q2.D
unnamed: LED1.A, Q4.G, U3.P$34 (13)
unnamed: 16X2.10, U3.P$11 (2)
unnamed: JP2.1, R21.1
unnamed: C1.2, C4.1, IC1.14 (OUT), R1.2
unnamed: R10.1, U1.7 (IN)
unnamed: 16X2.9, U3.P$10 (3)
unnamed: C6.1, IC1.2 (-IN), R2.2, R5.1
unnamed: C6.2, IC1.1 (OUT), R5.2, R6.1, U1.3 (NC)
unnamed: C12.1, C13.1, R12.2, R14.1
unnamed: C13.2, IC1.8 (OUT), IC1.9 (-IN), IC5.3 (IN-), TP1.2 (-)
unnamed: 16X2.8, U3.P$9 (4)
unnamed: 16X2.7, U3.P$8 (5)
unnamed: 16X2.6, U3.P$7 (6)
unnamed: 16X2.5, U3.P$6 (7)
unnamed: IC4.15 (S3), RN1.3, U$9.P$3 (NC)
unnamed: IC4.14 (R3), RN1.2, U$9.P$1 (NO)
unnamed: IC6.1 (ADJ), R3.2, R4.2
unnamed: IC4.11 (S2), RN1.5, U$8.P$3 (NC)
unnamed: IC4.12 (R2), RN1.4, U$8.P$1 (NO)
unnamed: 16X2.2, TM1.S
unnamed: IC4.1 (Q3), U3.P$4 (9)
unnamed: IC4.6 (R1), RN1.6, U$5.P$1 (NO)
unnamed: 16X2.4, U3.P$5 (8)
unnamed: IC4.3 (S0), RN1.9, U$6.P$3 (NC)
unnamed: IC4.4 (R0), RN1.8, U$6.P$1 (NO)
unnamed: IC4.7 (S1), RN1.7, U$5.P$3 (NC)
unnamed: IC4.10 (Q2), U3.P$3 (10)
unnamed: J1.2, U3.P$23 (5V)
unnamed: Q3.S, U2.2 (GND)
SCK: IC5.7 (CLK), U3.P$18 (SCK)

Notes on the sheet:
10 kHz Astable
Frequency Divider (1/2 50% Duty Cycle)
Transimpedance Amplifier
Inverter
10x gain 5kHz band-pass
Low-pass filter 2nd-order Butterworth
5kHz clock low => LED ON => TIA output higher to raise (-) voltage => 10x BP output lower to reduce (-) voltage => inverter output higher to raise (-) voltage 5kHz low => N.C. [lower in LED ON] selected 5kHz higher => N.O. [lower in LED OFF] selected SO output always lower
48 kHz
1.6 kHz

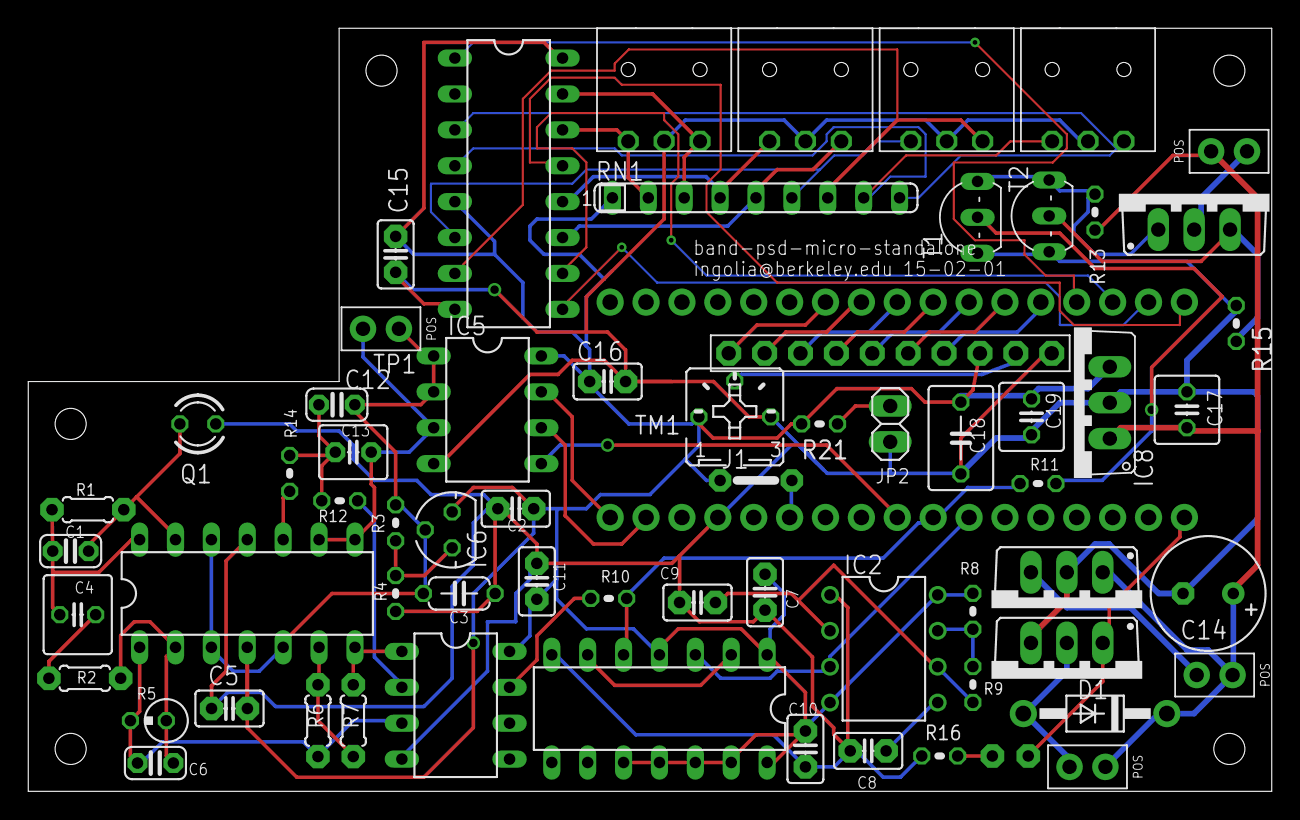
[picture p89: board band-psd-micro-standalone.brd from above]

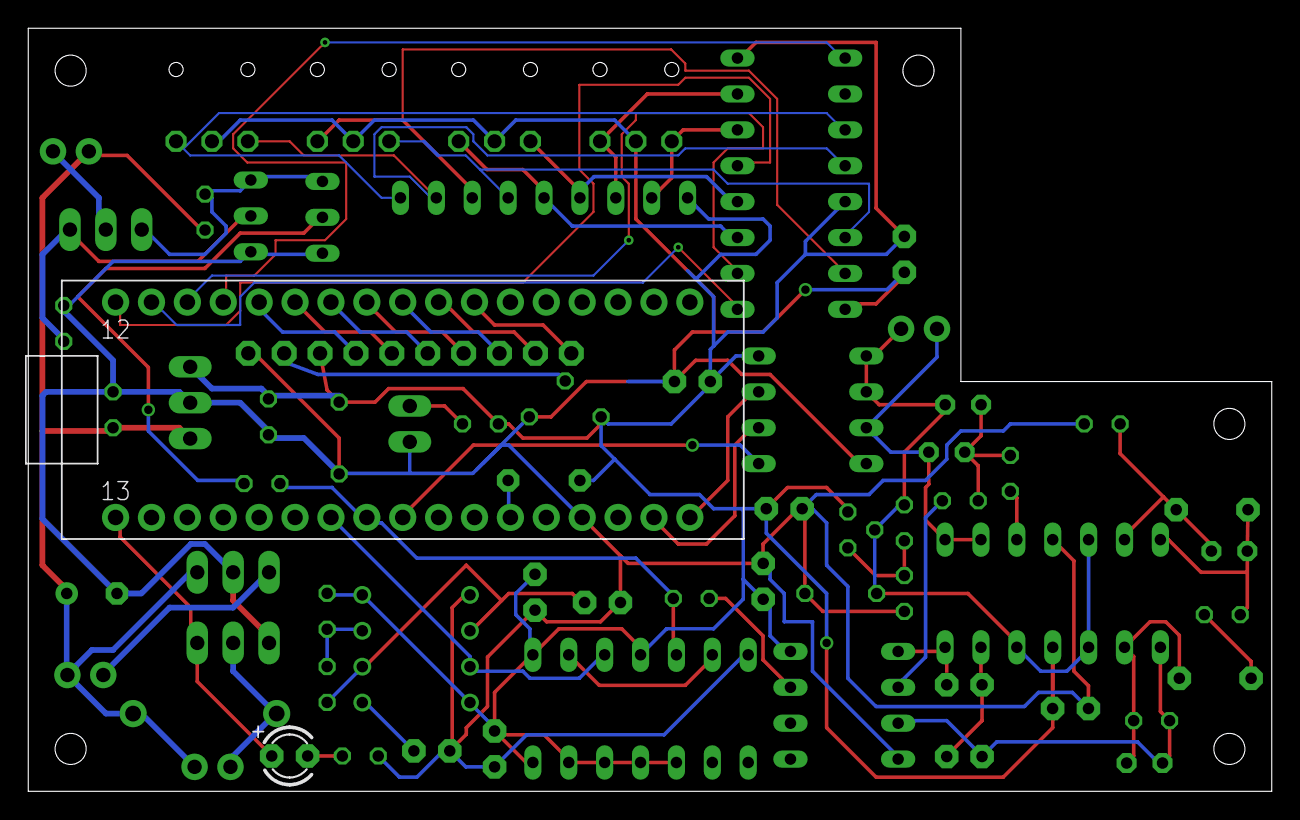
[picture p90: board band-psd-micro-standalone.brd from below]

Board: 2 copper layers, 88.0 x 54.0 mm, 71 parts (2 on the bottom side), 56 nets.

Other parts of the board:
U$1, U$2, U$3, U$4, U$7: M2MOUNT
