ingolia-lab/turbidostat-development/(commit log)

2015-01-04 Phase-sensitive detector for nepholometry
    [band psd v1.1 shield.brd, band psd v1.1 shield.sch, band-psd1.1-shield1.0-bom.csv]
2015-01-04 Updated to use MCP3301 for ADC on stand-alone
    [band psd v1.1 shield.brd, band psd v1.1 shield.sch, band-psd1.1-shield1.0-bom.csv]
2015-01-04 Removed tPlace annotations for push-button switch extending off of board in favor of tDocu
    [band psd v1.1 shield.brd, band psd v1.1 shield.sch]
2015-01-04 Updated filenames for no version numbers in filename
    [band-psd-micro-standalone.brd, band-psd-micro-standalone.sch, band-psd-miro-standalone-bom.csv]
2015-01-06 Parts list for DigiKey order
    [band-psd-micro-standalone-bom-digikey.csv, band-psd-micro-standalone-bom.csv]
2015-01-13 SketchUp model for original band and for PSD board
    [500ml band with TSAL v4.skp, band psd micro standalone 15-01-04.skp]
2015-01-13 adjusted dimensions and orientation of bare PCB with M2 mounting dummies
    [band psd micro standalone 15-01-04.skp]
2015-01-15 Finished enclosing tall part of the board
    [band psd micro standalone 15-01-04.skp, case for band psd micro standalone 15-01-04.skp]
2015-01-15 Finished covering component side of casing
    [case for band psd micro standalone 15-01-04.skp]
2015-01-15 Finished basic enclosure for component side and all around
    [case for band psd micro standalone 15-01-04.skp]
2015-01-15 Tabs for mounting a back cover
    [case for band psd micro standalone 15-01-04.skp]
2015-01-16 Fixed 10.5 spacing between pushbutton switches
    Added holes for 3.5mm jack for motor, DC IN, and pushbuttons
    [case for band psd micro standalone 15-01-04.skp]
2015-01-19 Fixed a minor flaw in which Arduino input pin is connected on the wrong side of the base resistor of the LED control and so never reads positive
    [band-psd-micro-standalone.brd, band-psd-micro-standalone.sch]
2015-01-19 Test control firmware for Micro to read SPI from analog-digital converter and record state of oscillators while switching the motor on and off
    [band-psd-micro-standalone_test.ino]
2015-01-19 Housing for standalone board with Arduino Micro next to 500 ml band
    [500ml band psd micro standalone 15-01-04.skp, 500ml band psd micro standalone 15-01-04.stl]
2015-01-27 Enlarged board, included 5V regulator on board, more decoupling, 4 buttons on 4 PCIO pins
    [band-psd-micro-standalone.brd, band-psd-micro-standalone.sch]
2015-01-28 Fixed up filter design -- topology of high-gain bandpass and component values for low-pass
    [band-psd-micro-standalone.brd, band-psd-micro-standalone.sch]
2015-01-28 Better wiring for push-buttons (to PCINT pins) and LCD (allow INT)
    [band-psd-micro-standalone.brd, band-psd-micro-standalone.sch]
2015-01-29 Started routing power supply
    Started part numbers for filter components
    [band-psd-micro-standalone.brd, band-psd-micro-standalone.sch]
2015-01-31 Specific parts for all analog components
    [band-psd-micro-standalone.brd, band-psd-micro-standalone.sch]
2015-02-01 Routed most of board except push-buttons and latch
    [band-psd-micro-standalone.brd, band-psd-micro-standalone.sch]
2015-02-02 Finished routing traces, all DRC okay
    [band-psd-micro-standalone.brd, band-psd-micro-standalone.sch]
2015-02-02 Finished placement labels and added test point
    [band-psd-micro-standalone.brd, band-psd-micro-standalone.sch]
2015-02-02 Finished BOM part assignments
    [band-psd-micro-standalone.brd, band-psd-micro-standalone.sch]
2015-02-02 Finished BOM attributes needed for 15-02-01 test fabrication
    [band-psd-micro-standalone-bom.csv, band-psd-micro-standalone.brd, band-psd-micro-standalone.sch]
2015-02-03 Automatically parse BOM table
2015-02-03 Finished script to extract a Digi-Key BOM and a parts list for assembly
2015-02-03 Parts list and assembly for 15-02-01 PCB
2015-02-03 Remove old .numbers BOM
2015-02-03 Fixup extraneous space in part #
    [band-psd-micro-standalone.brd, band-psd-micro-standalone.sch]
2015-02-14 Spice model of the phase-sensitive detector circuit
2015-06-11 New "DSP" amplifier i.e. control LED from microcontroller and no invert / switch / average in hardware
    [band-dsp-micro.brd, band-dsp-micro.sch]
2015-06-13 Finalized minimal turbidostat circuit with Arduino Micro control
    [band-dsp-micro.brd, band-dsp-micro.sch]
2015-06-24 Model of DSP micro board and start on housing with screw "platforms"
    [band dsp micro.skp]
2015-06-24 Housing for PCB including screw recesses
    [band dsp micro.skp]
2015-06-26 Created one-piece housing with separate back, and mounting points for motor clip
    [500ml dsp-micro TSAL.skp]
2015-06-26 Separated PCB housing and bottle band into two units with a square protrusion from the PCB housing into the band Reorient prints for minimal support wiht no supports in the "middle" of the housing
    [500ml dsp-micro TSAL print 2015-06-26.skp, 500ml dsp-micro TSAL.skp, band dsp micro.skp]
2015-07-09 Thickened all walls of the housing
    [500ml dsp-micro TSAL.skp]
2015-07-09 Fixed up interface between band and the main housing body
    [500ml dsp-micro TSAL.skp]
2015-07-09 Laid out new housing for printing, in 3 pieces
    [150708 print 500ml dsp-micro TSAL.skp, 150708 print 500ml dsp-micro TSAL.stl]
2015-07-10 Changed out screw holes for 2mm diameter mounting pegs
    [150708 print 500ml dsp-micro TSAL.skp, 150708 print 500ml dsp-micro TSAL.stl]
2015-07-12 Ordering plans for first round of stand-alone Arduino Micro doing DSP PSD
    [band-dsp-micro-bom-raw.csv]
2015-07-13 Updated parts list based on first round of building turbidostats
    [band-dsp-micro-bom-raw.csv, band-dsp-micro.brd, band-dsp-micro.sch]
2016-10-10 Moved hole for 1/8 in jack for motor connection
    [150708 print 500ml dsp-micro TSAL.skp]
2016-10-22 Right part number for dual op amp and socket
2016-11-12 Teensy-based nephelometer board using on-board ADC
    [band-dsp-teensy.brd, band-dsp-teensy.sch]
2016-11-12 programmable gain amplifier incorporated
    [band-dsp-teensy.brd, band-dsp-teensy.sch]
2016-11-14 Stackable motor controller board w/ 3.3V control; USB versus wall power; test order for components
    [band-dsp-teensy.brd, band-dsp-teensy.sch, band-motor-teensy.brd, band-motor-teensy.sch, test-teensy.csv]
2016-11-26 Laid out circuit for teensy nephelometer
    [band-dsp-teensy.brd, band-dsp-teensy.sch, band-motor-teensy.sch]
2016-11-27 Designed motor power board to stack on nephelometer or run over RJ11 cable
    [band-dsp-teensy.brd, band-dsp-teensy.sch, band-motor-teensy.brd, band-motor-teensy.sch]
2016-11-29 Motor control with transistor gating MOSFET, shutoff when disconnected
    [band-dsp-teensy.brd, band-dsp-teensy.sch, band-motor-teensy.brd, band-motor-teensy.sch]
2016-11-29 Simulation of motor control circuit
    [band-motor-teensy.brd]
2016-12-16 Corrected resistor divider
    [band-dsp-teensy.brd, band-dsp-teensy.sch]
2016-12-19 Teensy firmware to strobe LED and control SPI PGA
2017-01-11 Revised detector board circuit, picked filter values, finalized parts
    [band-dsp-teensy.brd, band-dsp-teensy.sch, band-motor-teensy.brd, band-motor-teensy.sch]
2017-01-18 Finalized parts and components for 10kHz band-pass etc
    [band-dsp-teensy.brd, band-dsp-teensy.sch]
2017-01-18 Fixed really dumb lack of trace to a test pin
    [band-dsp-teensy.brd]
2017-02-10 Frequency & ADC tuning; measurement; simple event loop
2017-02-11 Separate 3V3 supply for analog circuits. Guard ring for TIA
    [band-dsp-teensy.brd, band-dsp-teensy.sch]
2017-02-11 Added manual pumping with choice of motor
2017-02-22 Abstraction for a Pump
2017-02-27 Switched trophostat to target a fuzzy range
2017-02-27 New turbidostatic controller with a tuned periodic mix from two pumps
2017-03-03 Set up pins early and dont use pinMode after SPI.begin
2017-03-20 Added # signs and changed printouts in places. Added pump stop commands to the end of every controller program. Expanded the useTestNephel() function to allow escape from it. All changes are initiale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
    [band-dsp-teensy.ino]
2017-06-03 Feather-based board with external ADC
    [band-dsp-feather.brd, band-dsp-feather.sch, band-dsp-micro.brd, band-dsp-teensy.brd]
2017-06-05 Feather motor controller board with ESD protection and up to 4 motors or 2 motors plus stepper
    [band-dsp-feather.brd, band-motor-feather.brd, band-motor-feather.sch]
2017-06-07 Finalized Feather nephelometer with separate ADC and 4 robust motor controls
    [band-dsp-feather-bom.csv, band-dsp-feather.brd, band-dsp-feather.sch, band-motor-feather-bom.csv, band-motor-feather.brd, band-motor-feather.sch]
2017-06-19 Firmware for new Feather based boards
2017-06-20 Update for feather boards -- pins, no EEPROM params, cleaner parameter setting
2017-06-21 syringe pump driver
2017-06-30 Minor updates after test assembly
    [band-dsp-feather-bom.csv, band-dsp-feather.brd, band-dsp-feather.sch, band-motor-feather-bom.csv, band-motor-feather.brd, band-motor-feather.sch]
2017-08-17 Hierarchy of turbidostat variants including multi-pump algorithms
2017-09-28 reorganized old versions
    [band-dsp-micro-bom-raw.csv, band-dsp-micro.brd, band-dsp-micro.sch, band-psd-micro-standalone-bom-digikey.csv, band-psd-micro-standalone-bom.csv, band-psd-micro-standalone.brd, band-psd-micro-standalone.sch]
2017-09-29 Reorganization and moving data sheets out of VC
    [band-dsp-teensy.brd, band-dsp-teensy.sch, band-motor-teensy.brd, band-motor-teensy.sch, band-psd-micro-standalone.sch, test-teensy.csv]
2017-09-29 Rearranging and adding part ordering information
    [band-dsp-feather-bom.csv, band-dsp-feather.brd, band-dsp-feather.sch, band-motor-feather-bom.csv, band-motor-feather.brd, band-motor-feather.sch, band-single-feather-bom.csv, band-single-feather.brd]
2017-09-29 More rearrangement especially ordering information
    [band-dsp-feather-bom.csv, band-dsp-feather.brd, band-dsp-feather.sch, band-dsp-teensy.csv, band-motor-feather-bom.csv, band-motor-feather.brd, band-motor-feather.sch]
2017-09-29 Exported native and STL format from Fusion
    [150708 print 500ml dsp-micro TSAL.skp, 150708 print 500ml dsp-micro TSAL.stl, 250 ml band v9.f3d, 250 ml bottle.stl, 500 ml band v12.f3d, 500 ml bottle.stl, 500ml band psd micro standalone 15-01-04.skp, 500ml band psd micro standalone 15-01-04.stl]
2017-12-06 Switch media automatically
2018-01-04 Add virtual override for turbidity-controlled pumping
2018-03-13 Pullup resistor to shut off motors during startup with high-Z pin on microcontroller. Replaced obsolete flyback diode.
    [band-single-feather-bom.csv, band-single-feather.brd, band-single-feather.sch]
2018-07-09 Assembling the electronics
2018-07-14 Illustrated LED assembly
2018-07-14 Illustrated Feather header assembly
2018-07-14 Notes on wiring the pump input
2018-07-14 Split off housing assembly into a separate file
2018-07-14 Split off fluidics and pump
2018-07-14 Instructions for mounting and wiring the pump
2018-07-14 Picture of assembled system
2018-07-15 Pictures of housing assembly
2018-07-15 Wrote instructions for assembling housing
2018-07-15 Edits to housing assembly instructions
2018-07-20 Corrected syringe filter description
2018-07-29 Part number for JST cable
